embedded-pro/e-inverted-pendulum-hardware/docs/architecture.md

# Architecture

## Block diagram

```mermaid
graph LR
    BAT[3S LiPo 9.0-12.6 V] --> XT30[XT30] --> FUSE[Fuse 4 A] --> PP[Back-to-back PMOS AO4805<br/>on/off + reverse + soft-start]
    PP --> VM[VM bus<br/>SMBJ15A + 220 uF]
    VM --> DRV[DRV8711 + 4x CSD88537ND<br/>Rsense 2x 50 mOhm]
    DRV --> ML[Left MG310 + Hall A/B encoder]
    DRV --> MR[Right MG310 + Hall A/B encoder]
    VM --> DIV[VBAT divider] --> MCU
    VM --> BUCK[TPS62933 -> 5V0] --> LDO[TLV75533 -> 3V3]
    BUCK --> ENCP[Encoder VCC]
    ML -->|A B Z| BUF[ESD + SN74LVC3G17] --> MCU
    MR -->|A B Z| BUF
    LDO --> MCU[STM32WB55RGV6<br/>SMPS 10 uH + 10 nH]
    MCU -->|TIM1 CH1-4, BKIN| DRV
    MCU -->|SPI1| DRV
    MCU -->|SPI1| FLASH[W25Q16]
    MCU -->|SPI2 + DRDY| IMU[MPU-6500]
    MCU -->|RF1| MLPF[MLPF-WB55-01E3] --> PI[pi tuning DNP] --> ANT[printed IFA]
    MCU --> DBG[STDC14: SWD + VCP]
    MCU -->|PA7 via AHCT buffer| RGB[12 RGB LEDs on 5V0]
    MCU --> UI[Status LED, Qwiic, EEPROM, NFC tag]
```

Pins: `docs/pinmap.md`. Parts and stock: `bom/parts.csv`, checked by `scripts/jlc_stock.py`.

## Power tree and budget

Numbers marked **A** are ASSUMPTIONS to replace with datasheet maxima during the schematic phase.

| Rail | Load | Current | Source |
|---|---|---|---|
| 3V3 | STM32WB55, CPU + radio (TX 0 dBm 8.8 mA, SMPS bypass) | 30 mA | DS11929 radio current table; CPU allowance **A** |
| 3V3 | MPU-6500 accel + gyro | 3.5 mA | **A**, check the MPU-6500 datasheet |
| 3V3 | W25Q16 program/erase peak | 25 mA | **A**, check the W25Q16JV datasheet |
| 3V3 | Status LED at 2 mA, 2 × LVC3G17 | 5 mA | design choice |
| 3V3 | Qwiic allowance | 50 mA | design choice |
| **3V3 total** | | **≈ 115 mA** | TLV75533 (500 mA): (5.0 − 3.3) × 0.115 ≈ 0.20 W |
| 5V0 | 3V3 rail | 115 mA | above |
| 5V0 | 2 MG310 Hall encoders | 20 mA | **ASSUMPTION**, about 10 mA each for a Hall encoder board |
| 5V0 | 12 × WS2812B-2020-V6 at full white (D-035) | 432 mA | 12 mA per colour (WS2812B-2020-V6 p.1) × 3 × 12 |
| **5V0 total** | | **≈ 567 mA** | TPS62933 (3 A), L201 peak 0.83 A at 12.6 V (`docs/design-calcs.md`) |
| VBAT | 5V0 buck input at 9.9 V, η ≈ 0.85 | ≈ 340 mA | 5 × 0.567 / 0.85 / 9.9 |
| VBAT | Two motors at I_trip (peak) | 2 × 2.0 A | S0 (D-027) |
| VBAT | Two motors, continuous (rated) | 2 × 0.5 A | MG310 listing |
| **VBAT peak** | | **≈ 4.2 A** | 4 A fuse (1206FA-4A): 1.2 A continuous is within 75 % derating; 4.2 A recovery bursts (≪ 1 s) are 105 % of rating, which the fuse holds for ≥ 4 h; it opens at 250 % within 5 s (datasheet time-current table) |

## Safety chain (hardware part)

1. Power-on and reset (REQ-SYS-002, REQ-SAFE-009):
   - pull-downs on AIN1/AIN2/BIN1/BIN2 hold every bridge input low (tri-state);
   - a pull-down on SLEEPn keeps the DRV8711 asleep;
   - the DRV8711's SCS pull-down keeps SPI1 traffic from reaching it until firmware selects it.
2. A driver fault (nFAULT, open-drain) reaches TIM1_BKIN (PA6), which tri-states all four inputs in hardware with no firmware involved. It also reaches EXTI4 (PC4) to latch the fault (REQ-DRIVE-004).
3. Switching off the board while the wheels spin: the bridges' body diodes rectify the motor back-EMF onto VM, where the 220 µF and the SMBJ15A absorb it (HW-PWR-004, verified in S1).
4. The battery voltage is visible to the MCU (PC1) for the undervoltage fault (HW-PWR-006).
