embedded-pro/e-inverted-pendulum-hardware/docs/design-calcs.md

# Design calculations (Phase 1)

Generated by `python3 scripts/design_calcs.py`. Values feed `scripts/schgen/values.json` and the schematic generator; do not edit by hand.

| Block | Item | Value | Source |
|---|---|---|---|
| TPS62933F | f_sw | 1.2 MHz (RT pin to GND) | TPS62933 Table 7-1 / s9.3.5 (RT < 1 kOhm -> 1.2 MHz) |
| TPS62933F | R_FBB / R_FBT | 10k / 52.3k -> V_OUT 4.984 V (4.88-5.08 V over V_FB tolerance) | Eq. 1, R_FBB = 10 k recommended (s9.3.4); V_FB 784-816 mV (s8.5) |
| TPS62933F | L | 4.7 uH Sunlord SWPA4030S4R7MT (I_sat 3.2 A, I_rms 2 A); ripple 0.39 A at 9 V, 0.53 A at 12.6 V | Eq. 16 range 2.1-6.2 uH; ripple >= 10 % of 3 A for slope compensation (s10.2.2.7); peak at 0.3 A load ~0.6 A << I_sat; below I_HS_LIMIT 5.8 A only in a hard short |
| TPS62933F | C_OUT | 2 x 22 uF 25 V 0805 X5R (~22 uF effective at 5 V) + 100 nF | Table 10-2: 20 uF typ effective at 1.2 MHz / 5 V |
| TPS62933F | C_IN | 2 x 10 uF 25 V 0805 + 100 nF 50 V at the VIN pin | s10.2.2.9, s11 layout |
| TPS62933F | C_BST | 100 nF 16 V X7R | s10.2.2.5 |
| TPS62933F | C_SS | 47 nF -> t_SS = 6.8 ms (>= 6.8 nF minimum) | Eq. 6, I_SS 5.5 uA |
| TPS62933F | EN UVLO divider | R1 240k / R2 36k: start 9.11 V, stop 8.47 V, V_EN at 13.5 V = 1.83 V (< 5.5 V) | Eq. 3-5 (ideal R1 278k, R2 41.1k); stop at ~2.8 V/cell protects the LiPo, hysteresis >= 0.5 V (s9.3.6) |
| TLV75533P | C_IN / C_OUT | 1 uF 50 V X5R / 2.2 uF 25 V X5R (>= 0.47 uF effective) | SBVS320A s6.3, s8.1.1 |
| TLV75533P | dissipation | 0.20 W at 115 mA -> +45 C (R_thJA 231 C/W) | s6.4; load from docs/architecture.md |
| LSE | load caps | 2 x 6.8 pF C0G (computed 7.0 pF for C_L 6 pF, stray 2.5 pF) | AN2867 C_L formula (mcu-circuit-design s4); ST characterises LSE with 2 x 6.8 pF (DS11929 Table 41 n3) |
| LSE | drive | LSEDRV = 10 (firmware): g_m,crit ~0.67 uA/V vs 1.70 uA/V -> margin ~2.5 | DS11929 Table 54; NX3215SA C0 1.5 pF max, ESR 70 kOhm |
| HSE | crystal | NX2016SA-32MHZ-EXS00A-CS06654, no external caps (HSETUNE) | DS11929 Table 5 note 1 reference part; Table 52 C_L 6-8 pF, ESR <= 100 Ohm |
| VBAT sense | divider | 100k / 27k: ratio 0.2126, 12.6 V -> 2.679 V, 13.5 V -> 2.87 V | headroom below VDDA 3.3 V |
| VBAT sense | source impedance | 21.3 kOhm (< 50 kOhm R_AIN max), 100 nF bucket >> 20 x 5 pF C_ADC, tau 2.1 ms | DS11929 Table 73; analog-circuit-design s6 |
| VBAT sense | ratio error | +/-1.57 % worst case with 1 % parts (+/-66 mV per cell); calibrate per board + VREFINT | sensitivity of R2/(R1+R2) |
| Power path | V_GS at 9.0 V | -4.5 V (AO4805 R_DS(on) <= 26 mOhm at -4.5 V; limit +/-20 V; BZT52C15 clamps transients) | 100k gate-source / 100k to GND through the switch (S1) |
| Power path | V_GS at 13.5 V | -6.8 V (AO4805 R_DS(on) <= 26 mOhm at -4.5 V; limit +/-20 V; BZT52C15 clamps transients) | 100k gate-source / 100k to GND through the switch (S1) |
| Power path | soft start | 47 nF + 1k gate-to-VBAT (Miller): I_G ~0.08 mA -> ~1.7 V/ms, inrush ~0.48 A for ~7 ms | S1: 0.69 A peak with the 3.34 W logic load (D-035), 7.2 ms 10-90 % rise (was 44.6 A on hot plug with the Phase 1 values) |
| Power path | hot plug, switch off | 1 uF gate-source cap: V_GS step = -12.6 x 47n/(47n+1u) = -0.57 V (< |V_th,min| 1.0 V), FET stays off | S1: VBAT stays at 0.002 V (was 10.5 V with the Phase 1 values) |
| Power path | turn-off | tau = 100k x (1 uF + 47 nF) = 105 ms; don't switch off while the motors are driven | S1 regen cases: FET energy <= 7 mJ |
| Power path | TVS | SMBJ15A after the FETs: V_RWM 15 V > 13.5 V, V_C 24.4 V < 30 V (AO4805), 32 V (TPS62933) | Littelfuse SMBJ p.2; must not sit before the reverse-polarity FETs |
| DRV8711 | VM | 10 nF 50 V + 220 uF 35 V bulk; per bridge 10 uF 25 V 0805 + 100 nF 50 V at the half-bridges | SLVSC40 Critical Components p.4; power-pcb-layout s3.1 hot loop |
| DRV8711 | VCP / CP1-CP2 | 1 uF 50 V X5R VCP-to-VM / 100 nF 50 V X7R (>= VM + 12 V = 25.5 V) | SLVSC40 p.3-4 |
| DRV8711 | V5 / VINT / BEMF | 100 nF / 1 uF / 1 nF C0G to GND | SLVSC40 p.3-4 |
| DRV8711 | pull-ups | nFAULT, nSTALL 10k; SDATO (open-drain, shared MISO) 2.2k -> tau ~66 ns with 30 pF | SLVSC40 p.3; SPI <= 4 MHz (p.8) |
| DRV8711 | SLEEPn | 10k pull-down: no internal pull, keeps the driver asleep while the MCU is in reset | SLVSC40 p.3; AINx/BINx/RESET/SCS have internal pull-downs |
| DRV8711 | low-side clamps | SS34 Schottky from GND to each phase node: freewheel at -0.36 V instead of the -0.73 V body diode | S2; DRV8711 phase pins abs max -0.6 V (SLVSC40 Abs Max) |
| DRV8711 | Rsense | 50 mOhm 1206 1 W 75 ppm/C; 2.0 A trip -> 0.2 W; ISGAIN 20, TORQUE 186 | D-027; S0 (simulation/REPORT.md); Eq. 1 p.11 |
| DRV8711 | ISENSE filter | 0 Ohm fitted in each leg, 1 nF DNP across (fit 27-33 Ohm + 1 nF if noisy: RC 50-60 ns) | SLVSC40 p.16 Fig. 6 (symmetric, <= 500 Ohm, matched 1 %) |
| DRV8711 | firmware | IDRIVE 00 (50/100 mA, default); TBLANK >= 1.2 us (sense amp settling); SCLK <= 4 MHz; SCS active-high GPIO | SLVSC40 p.7-8 |
| Encoders | input RC | 100 Ohm + 1 nF -> f_c 1.59 MHz (> 2 x 105 kHz max channel rate), rise 220 ns | S0 encoder rate; analog-circuit-design s5 |
| Encoders | OC pull-ups (DNP) | 2.2k to encoder VCC: OK to ~500 lines at full speed; for 1000-line OC encoders fit 1k and reduce C to 220 pF | tau = R x (1 nF + cable) |
| Encoders | buffer | SN74LVC3G17 at 3V3: V_T+ <= 1.87 V, inputs 5.5 V tolerant with I_off | SCES470D p.3-4 |
| Qwiic I2C | pull-ups | 2.2k (window 967-3541 Ohm, Fast mode, C_b 100 pF) | SLVA689A |
| Status LED | series R | green 470 Ohm on PB0 (V_F 2.45 V at 2 mA -> ~1.8 mA) | KT-0603G IF-VF curve p.5 |
| RGB LEDs | chain | 12 x WS2812B-2020-V6 on +5V, 12 mA per colour, 36 mA per LED at full white -> 432 mA for the chain; 100 nF per LED, 10 uF at the chain input | WS2812B-2020-V6 p.1 (12 mA per channel), p.3 (36 mA colour mix), p.6 (C_n 100 nF); 10 uF ASSUMPTION |
| RGB LEDs | data level | LED V_IH = 0.55 VDD = 2.75 V at 5 V; MCU V_OH >= VDD - 0.4 = 2.9 V (0.15 V margin direct), so SN74AHCT1G125 on +5V: V_IH 2.0 V (0.9 V margin), 5 V output | WS2812B-2020-V6 p.3; SCLS378L p.3; DS11929 Output voltage characteristics (VOH, 8 mA) |
| RGB LEDs | data line | 10k pull-down at the buffer input (data low while PA7 floats in reset); 33 Ohm source termination at the buffer output | SCLS378L note 3 (inputs must not float); mcu-circuit-design s9 |
| +5V budget | load | RGB chain 432 mA + 3V3 LDO 115 mA + encoders 20 mA = 567 mA; L201 peak 0.83 A at 12.6 V << I_sat 3.2 A, TPS62933F 3 A | docs/architecture.md; L201 ripple row above |
| BOOT0 | entry | 10k pull-down, no button: test pad TP302 to +3V3 at reset, or nSWBOOT0 / nBOOT0 option bytes over SWD | mcu-circuit-design s3; RM0434 option bytes |
