embedded-pro/e-inverted-pendulum-hardware/docs/pinmap.md

# Pin map: STM32WB55RGV6 (VFQFPN68)

- **Source of truth:** `pin-data/pinmap.csv`.
- **Validation:** `scripts/check_pinmap.py --firmware ../e-inverted-pendulum`.
- **Package data:** `pin-data/stm32wb55rgvx_vfqfpn68.csv`, extracted by
  `scripts/extract_pin_data.py` from KiCad 10's `MCU_ST_STM32WB:STM32WB55RGVx` symbol (identical to KiCad 9's), which is
  generated from ST's STM32_open_pin_data. Spot-checked against DS11929 Rev 11 Tables 16 and 18.

The plan called for a CubeMX `.ioc`. STM32CubeMX can't run in this environment, so the script
replaces it for bonding, alternate functions, EXTI uniqueness and firmware parity. Generating the
`.ioc` (clock tree, SMPS, LSE) is left for someone with CubeMX installed. It doesn't block the
schematic.

## What the check enforces

1. Every pin is bonded on VFQFPN68.
2. Every alternate function or ADC channel exists on its pin.
3. One signal per pin. The only shared net is `DRV_NFAULT`, which reaches PA6 (TIM1_BKIN) and
   PC4 (EXTI4), as the firmware expects.
4. Unique EXTI lines. In use: 0 (button), 2 (NFC GPO), 3 and 5 (encoder index; idle with the MG310, D-028),
   4 (driver fault), 6 (IMU data-ready).
5. Firmware parity: all 26 pins declared in `targets/platform_implementations/st/*.hpp` sit
   on the same pins.

## Firmware-visible changes

None to existing pins. New signals for the firmware's board target:

| Signal | Pin | Use |
|---|---|---|
| FLASH_CS | PA15 | W25Q16 on SPI1 (shared with the DRV8711; mode 0 suits both) |
| VBAT_SENSE | PC1 / ADC1_IN2 | battery voltage, 100 k/27 k divider |
| LED_RGB | PA7 / TIM17_CH1 | 12 × WS2812B-2020-V6 chain through an SN74AHCT1G125 (D-035); green status LED stays on PB0 |
| I2C3 SCL/SDA | PB10 / PB11 | Qwiic expansion, M24C64 EEPROM (0x50), ST25DV04KC NFC tag (0x53/0x57) |
| NFC_GPO | PA2 / EXTI2 | ST25DV04KC GPO, open drain with a 10 k pull-up (D-030) |
| DRV_STALLN | PB2 | optional DRV8711 nSTALL input |

## Consequences

- **No index:** the MG310 encoders are A/B only; PC5 and PC3 read low (D-028).
- **No SWO:** PB3 is SPI1_SCK.
- **No USB:** PA11 is TIM1_CH4 (D-009).
- **SWD only:** PA15 (JTDI) is FLASH_CS, so firmware must not enable JTAG.
- **Reset-safe bridge:** PA8–PA11 and PB8 get pull-downs so the bridge stays tri-stated and the
  driver asleep while the MCU is in reset (HW-DRV-005).
