embedded-pro/e-inverted-pendulum-hardware/docs/images/3d_top.png

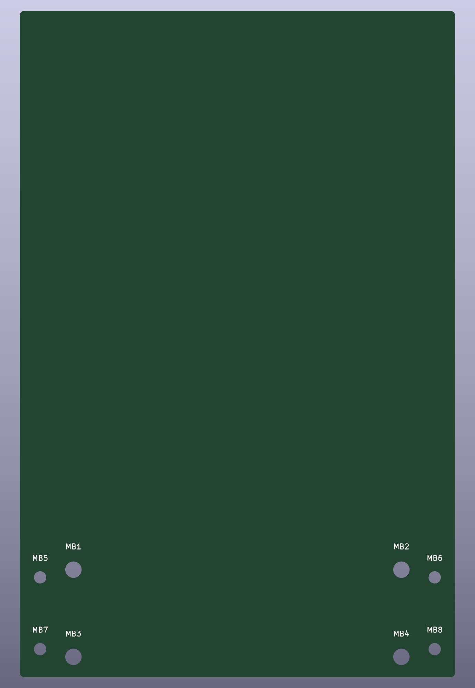
docs/images/3d_top.png
