embedded-pro/e-inverted-pendulum-hardware/docs/images/bottom.png

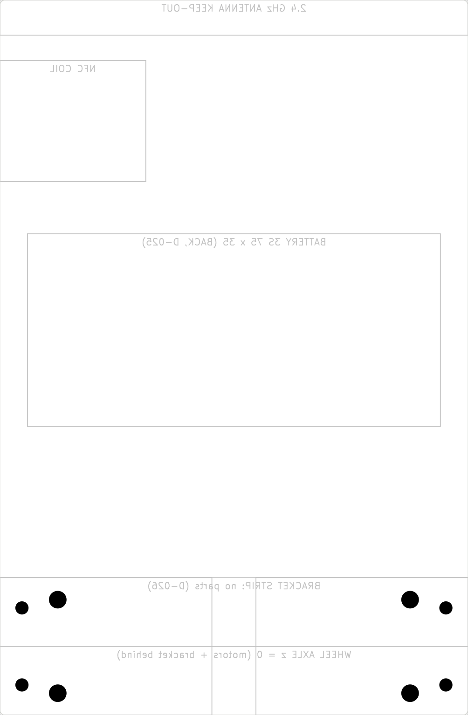
docs/images/bottom.png
