embedded-pro/e-inverted-pendulum-hardware/docs/images/L1_F.Cu.png

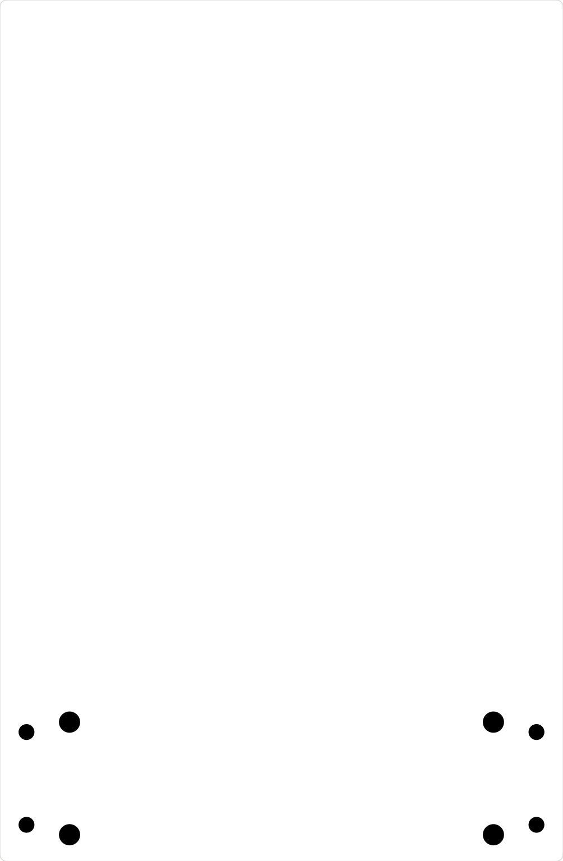
docs/images/L1_F.Cu.png
