embedded-pro/e-inverted-pendulum-hardware/docs/images/overview.png

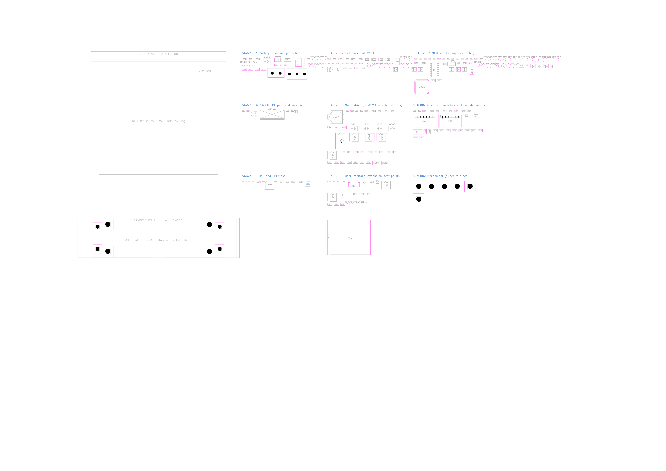
docs/images/overview.png
