embedded-pro/e-inverted-pendulum-hardware/docs/images/placement.png

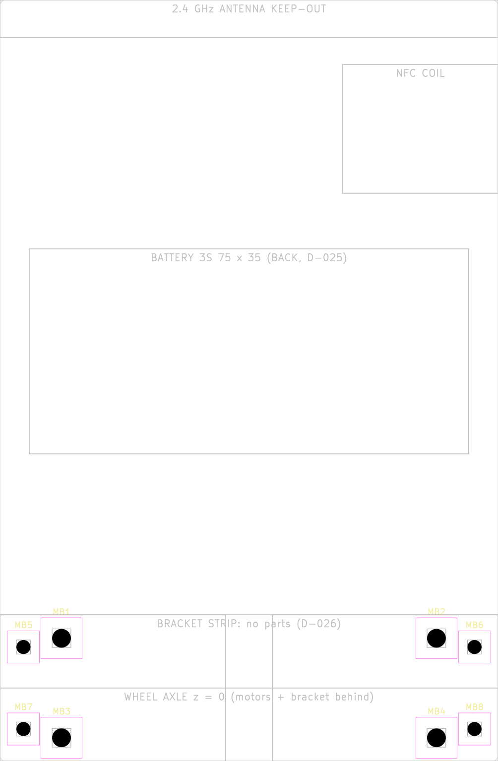
docs/images/placement.png
