embedded-pro/e-inverted-pendulum-hardware/simulation/plots/s1_regen.png

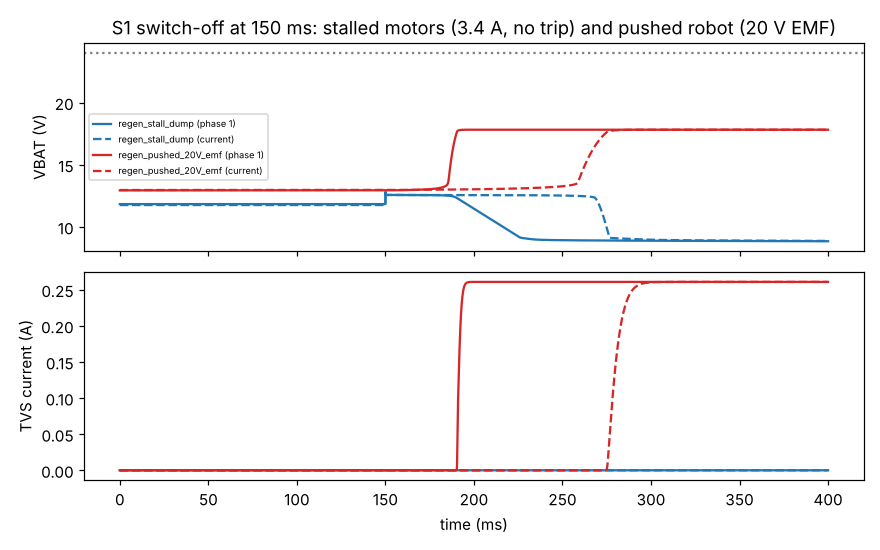
simulation/plots/s1_regen.png
