embedded-pro/e-inverted-pendulum-hardware/simulation/plots/s1_switch_on.png

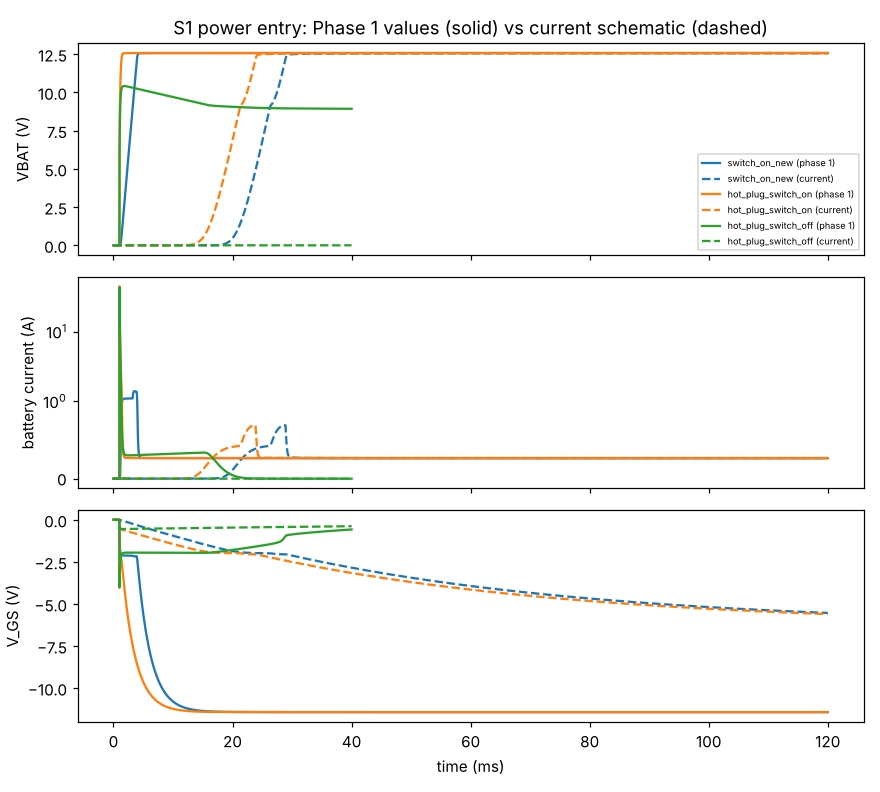
simulation/plots/s1_switch_on.png
