embedded-pro/e-inverted-pendulum-hardware/simulation/plots/s2_edges.png

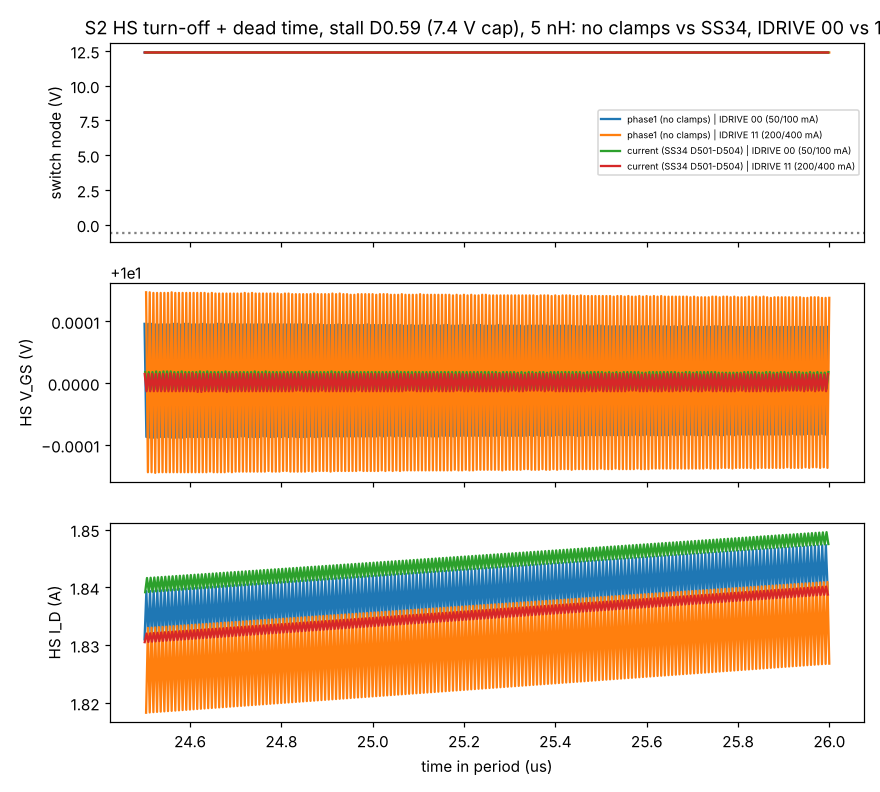
simulation/plots/s2_edges.png
