embedded-pro/e-inverted-pendulum-hardware/simulation/plots/s3_bus.png

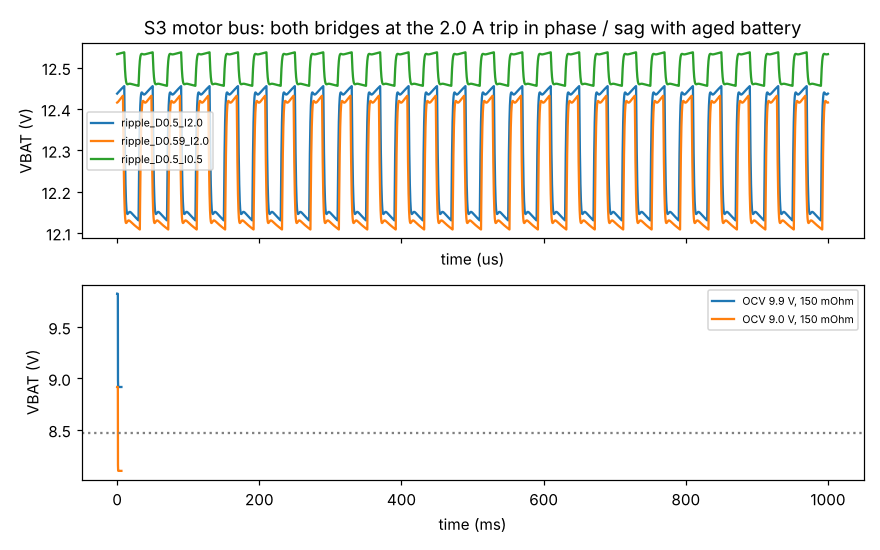
simulation/plots/s3_bus.png
