embedded-pro/e-inverted-pendulum-hardware/simulation/plots/s4_rails.png

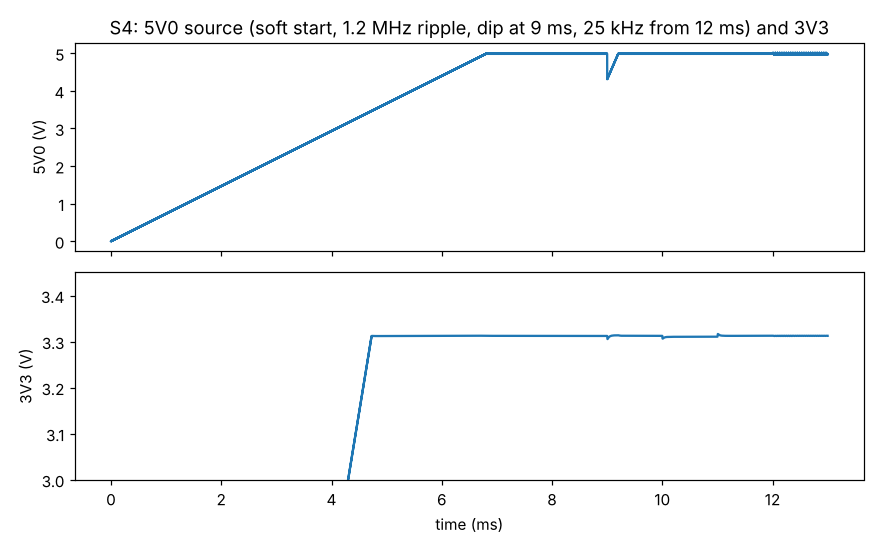
simulation/plots/s4_rails.png
