embedded-pro/e-inverted-pendulum-hardware/simulation/plots/sizing_recovery.png

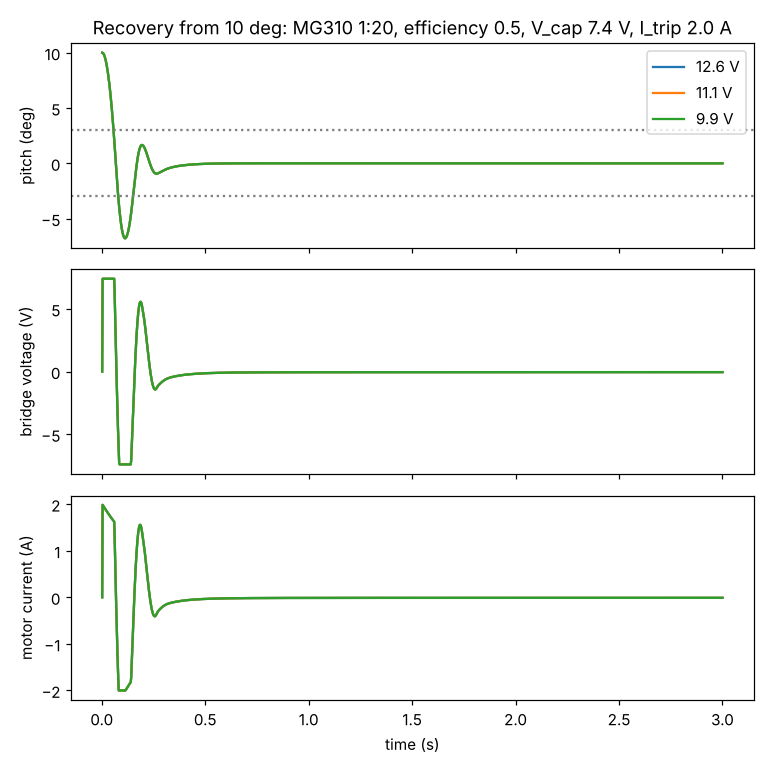
simulation/plots/sizing_recovery.png
