embedded-pro/e-inverted-pendulum-hardware/bom/bom.csv

group | function | mpn | lcsc | qty | notes
schematic | 47nF 50V | CL10B473KB8NNNC | C1622 | 2 | C101,C205
schematic | 1uF 50V | CL10A105KB8NNNC | C15849 | 6 | C102,C209,C311,C313,C509,C512
schematic | 100nF 50V | CC0603KRX7R9BB104 | C14663 | 7 | C103,C203,C208,C503,C506,C510,C602
schematic | 10uF 25V | CL21A106KAYNNNE | C15850 | 5 | C201,C202,C502,C505,C805
schematic | 100nF 16V | CL05B104KO5NNNC | C1525 | 30 | C204,C301,C302,C303,C304,C305,C307,C312,C317,C511,C606,C610,C701,C703,C704,C801,C802,C803,C806,C807,C808,C809,C810,C811,C812,C813,C814,C815,C816,C817
schematic | 22uF 25V | CL21A226MAQNNNE | C45783 | 2 | C206,C207
schematic | 2.2uF 25V | CL10A225KO8NNNC | C23630 | 1 | C210
schematic | 4.7uF 10V | CL05A475MP5NRNC | C23733 | 3 | C306,C309,C314
schematic | 100pF 50V | CL05C101JB5NNNC | C26409 | 1 | C308
schematic | 10nF 50V | CL10B103KB8NNNC | C1589 | 3 | C310,C508,C702
schematic | 6.8pF 50V | CL05C6R8CB5NNNC | C318598 | 2 | C315,C316
schematic | 220u 35V | EEEFK1V221P | C178562 | 1 | C507
schematic | 1nF 50V | CL05C102JB5NNNC | C307441 | 1 | C513
schematic | 10uF 10V | CL10A106KP8NNNC | C19702 | 1 | C601
schematic | 1nF 50V | CL10B102KB8NNNC | C1588 | 4 | C604,C605,C608,C609
schematic | BZT52C15 | BZT52C15 | C2104 | 1 | D101
schematic | SMBJ15A | SMBJ15A | C83846 | 1 | D102
schematic | SS34 | SS34 | C8678 | 4 | D501,D502,D503,D504
schematic | green | KT-0603G | C12624 | 1 | D801
schematic | WS2812B-2020 | WS2812B-2020-V6 | C52917434 | 12 | D802,D803,D804,D805,D806,D807,D808,D809,D810,D811,D812,D813
schematic | 4A fast | 1206FA-4A | C2937379 | 1 | F101
schematic | PTC 100mA | SMD0805P010TF | C20975 | 1 | F601
schematic | BLM18PG221SN1D | BLM18PG221SN1D | C80165 | 1 | FB301
schematic | MLPF-WB55-01E3 | MLPF-WB55-01E3 | C2651048 | 1 | FL401
schematic | XT30 battery | XT30UPB-F30.G.Y | C108769 | 1 | J101
schematic | STDC14 | FTSH-107-01-L-DV-K | C5307809 | 1 | J301
schematic | Motor left,Motor right | S6B-PH-K-S(LF)(SN) | C157920 | 2 | J601,J602
schematic | Qwiic | SM04B-SRSS-TB(LF)(SN) | C160404 | 1 | J801
schematic | 4.7uH | SWPA4030S4R7MT | C57269 | 1 | L201
schematic | 10uH | LQM21FN100M80L | C162582 | 1 | L301
schematic | 10nH | LQG15HS10NJ02D | C77103 | 1 | L302
schematic | AO4805 | AO4805 | C3040596 | 1 | Q101
schematic | CSD88537ND | CSD88537ND | C117439 | 4 | Q501,Q502,Q503,Q504
schematic | 100k | 0603WAF1003T5E | C25803 | 3 | R101,R102,R104
schematic | 1k | 0603WAF1001T5E | C21190 | 1 | R103
schematic | 27k | 0603WAF2702T5E | C22967 | 1 | R105
schematic | 240k | 0603WAF2403T5E | C4197 | 1 | R201
schematic | 36k | 0603WAF3602T5E | C23147 | 1 | R202
schematic | 52.3k | 0603WAF5232T5E | C23198 | 1 | R203
schematic | 10k | 0603WAF1002T5E | C25804 | 11 | R204,R302,R515,R516,R518,R701,R702,R703,R704,R803,R810
schematic | 33 | 0603WAF330JT5E | C23140 | 2 | R301,R802
schematic | 0 | 0402WGF0000TCE | C17168 | 1 | R401
schematic | 0 | 0603WAF0000T5E | C21189 | 13 | R501,R502,R503,R504,R505,R506,R507,R508,R510,R511,R513,R514,R601
schematic | 50m | HoLR1206-1W-50mR-1%-75ppm | C601102 | 2 | R509,R512
schematic | 2.2k | 0603WAF2201T5E | C4190 | 3 | R517,R808,R809
schematic | 100 | 0603WAF1000T5E | C22775 | 4 | R604,R606,R608,R610
schematic | 470 | 0603WAF4700T5E | C23179 | 1 | R801
schematic | SS-12D10L5 | SS-12D10L5 | C319012 | 1 | SW101
schematic | TPS62933F | TPS62933FDRLR | C5219272 | 1 | U201
schematic | TLV75533P | TLV75533PDBVR | C404027 | 1 | U202
schematic | STM32WB55RGV6 | STM32WB55RGV6 | C401505 | 1 | U301
schematic | DRV8711 | DRV8711DCPR | C60013 | 1 | U501
schematic | TPD4E05U06QDQARQ1 | TPD4E05U06QDQARQ1 | C81353 | 3 | U601,U603,U801
schematic | SN74LVC3G17DCTR | SN74LVC3G17DCTR | C18213 | 2 | U602,U604
schematic | MPU-6500 | MPU-6500 | C50278 | 1 | U701
schematic | W25Q16JVSSIQ | W25Q16JVSSIQ | C131025 | 1 | U702
schematic | M24C64-RMN6TP | M24C64-RMN6TP | C79988 | 1 | U802
schematic | ST25DV04KC-IE8S3 | ST25DV04KC-IE8S3 | C5221752 | 1 | U803
schematic | SN74AHCT1G125 | SN74AHCT1G125DBVR | C7484 | 1 | U804
schematic | 32MHz | NX2016SA-32MHZ-EXS00A-CS06654 | C5441424 | 1 | Y301
schematic | 32.768kHz | NX3215SA-32.768K-STD-MUA-14 | C156244 | 1 | Y302
