embedded-pro/e-inverted-pendulum-hardware/mechanical/mass_budget.csv

item | qty | mass_g | z_mm | y_mm | shape | height_mm | depth_mm | source
axle | 1 | 0 | 0 | 18.8 | axle | 0 | 0 | Pivot (D-026): WHEELTEC U-bracket leg hole 18 mm from the base, base flat on the plate's back (0.8 mm half plate); z at the centre of the 25 mm strip, 12.5 mm above the bottom edge
pcb_plate | 1 | 33 | 52.5 | 0 | plate | 130 | 1.6 | D-024 outline 85 x 130 x 1.6 mm FR-4 at 1.85 g/cm3, spanning z -12.5..117.5 mm
pcb_components | 1 | 30 | 60 | -2 | point | 0 | 0 | ASSUMPTION populated-board estimate (all parts on the front, D-015), incl. NFC/EEPROM and PH connectors
battery_3s_1000mah | 1 | 85 | 57.5 | 11.8 | box | 35 | 22 | ASSUMPTION 3S 1000 mAh 75 x 35 x 22 mm flat on the back (D-025), z 40..75 mm
battery_cradle | 1 | 10 | 57.5 | 6 | point | 0 | 0 | ASSUMPTION printed cradle on 4 x M3
motor_mg310 | 2 | 65 | 0 | 18.8 | cylinder | 25 | 25 | ASSUMPTION MG310 1:20 with Hall encoder, 60-70 g (seller listings); axis on the wheel axle
bracket_wheeltec | 1 | 64 | 0 | 7.1 | point | 0 | 0 | derived: 2 mm steel U, base 102 x 25 + two 25 x 31 legs = 8.2 cm3 at 7.85 g/cm3; centroid between the base (y 1.8) and the legs (y 15.8)
screws_cables | 1 | 15 | 10 | 2 | point | 0 | 0 | ASSUMPTION bracket screws, motor cables
xt30_lead | 1 | 10 | 40 | -4 | point | 0 | 0 | ASSUMPTION XT30 plug and battery lead on the left edge
bumpers | 1 | 10 | 100 | 0 | point | 0 | 0 | ASSUMPTION nylon bumpers near the top
wheel | 2 | 30 | 0 | 18.8 | wheel | 65 | 26 | Owner: 65 mm wheels (2026-11-13); mass ASSUMPTION 30 g; excluded from body mass
