embedded-pro/e-inverted-pendulum-hardware/simulation/results/sizing_sweep.csv

v_cap | i_trip | efficiency | vbat | vbat_case | reflected_inertia | recover_10deg | settle_time_10deg | peak_current_10deg | peak_duty_10deg | max_recoverable_deg | cruise_v_1p0_mps | cruise_v_1p5_mps
7.4 | 1.0 | low | 12.6 | full | 0.0007999999999999999 | True | 0.382 | 1.0 | 0.5873015873015873 | 11.95703125 | 4.191046038652143 | 6.064569057978214
7.4 | 1.0 | low | 11.1 | nominal | 0.0007999999999999999 | True | 0.382 | 1.0 | 0.6666666666666667 | 11.95703125 | 4.191046038652143 | 6.064569057978214
7.4 | 1.0 | low | 9.9 | arm_min | 0.0007999999999999999 | True | 0.382 | 1.0 | 0.7474747474747475 | 11.95703125 | 4.191046038652143 | 6.064569057978214
7.4 | 1.0 | nominal | 12.6 | full | 0.0007999999999999999 | True | 0.192 | 1.0 | 0.5873015873015873 | 16.33984375 | 4.191046038652143 | 6.064569057978214
7.4 | 1.0 | nominal | 11.1 | nominal | 0.0007999999999999999 | True | 0.192 | 1.0 | 0.6666666666666667 | 16.33984375 | 4.191046038652143 | 6.064569057978214
7.4 | 1.0 | nominal | 9.9 | arm_min | 0.0007999999999999999 | True | 0.192 | 1.0 | 0.7474747474747475 | 16.33984375 | 4.191046038652143 | 6.064569057978214
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
