embedded-pro/e-inverted-pendulum-hardware/hardware/e-inverted-pendulum/e-inverted-pendulum.kicad_pcb

## KiCad design hardware/e-inverted-pendulum/e-inverted-pendulum.kicad_pcb (2026-11-14)

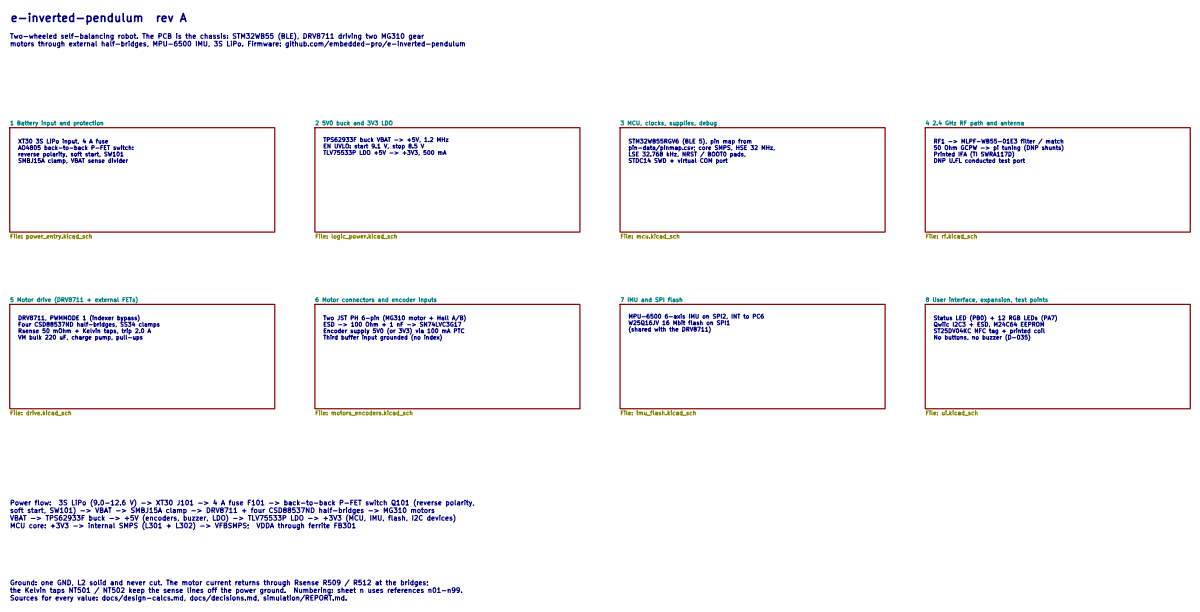
[picture p20: schematic e-inverted-pendulum.kicad_sch, e-inverted-pendulum: self-balancing robot chassis PCB]

Notes on the sheet:
Two JST PH 6-pin (MG310 motor + Hall A/B) ESD -> 100 Ohm + 1 nF -> SN74LVC3G17 Encoder supply 5V0 (or 3V3) via 100 mA PTC Third buffer input grounded (no index)
DRV8711, PWMMODE 1 (indexer bypass) Four CSD88537ND half-bridges, SS34 clamps Rsense 50 mOhm + Kelvin taps, trip 2.0 A VM bulk 220 uF, charge pump, pull-ups
RF1 -> MLPF-WB55-01E3 filter / match 50 Ohm GCPW -> pi tuning (DNP shunts) Printed IFA (TI SWRA117D) DNP U.FL conducted test port
MPU-6500 6-axis IMU on SPI2, INT to PC6 W25Q16JV 16 Mbit flash on SPI1 (shared with the DRV8711)
Status LED (PB0) + 12 RGB LEDs (PA7) Qwiic I2C3 + ESD, M24C64 EEPROM ST25DV04KC NFC tag + printed coil No buttons, no buzzer (D-035)
Two-wheeled self-balancing robot. The PCB is the chassis: STM32WB55 (BLE), DRV8711 driving two MG310 gear motors through external half-bridges, MPU-6500 IMU, 3S LiPo. Firmware: github.com/embedded-pro/e-inverted-pendulum
XT30 3S LiPo input, 4 A fuse AO4805 back-to-back P-FET switch: reverse polarity, soft start, SW101 SMBJ15A clamp, VBAT sense divider
e-inverted-pendulum rev A
TPS62933F buck VBAT -> +5V, 1.2 MHz EN UVLO: start 9.1 V, stop 8.5 V TLV75533P LDO +5V -> +3V3, 500 mA
Ground: one GND, L2 solid and never cut. The motor current returns through Rsense R509 / R512 at the bridges; the Kelvin taps NT501 / NT502 keep the sense lines off the power ground. Numbering: sheet n uses references n01-n99. Sources for every value: docs/design-calcs.md, docs/decisions.md, simula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
STM32WB55RGV6 (BLE 5), pin map from pin-data/pinmap.csv; core SMPS, HSE 32 MHz, LSE 32.768 kHz, NRST / BOOT0 pads, STDC14 SWD + virtual COM port
Power flow: 3S LiPo (9.0-12.6 V) -> XT30 J101 -> 4 A fuse F101 -> back-to-back P-FET switch Q101 (reverse polarity, soft start, SW101) -> VBAT -> SMBJ15A clamp -> DRV8711 + four CSD88537ND half-bridges -> MG310 motors VBAT -> TPS62933F buck -> +5V (encoders, buzzer, LDO) -> TLV75533P LDO -> +3V3 (M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

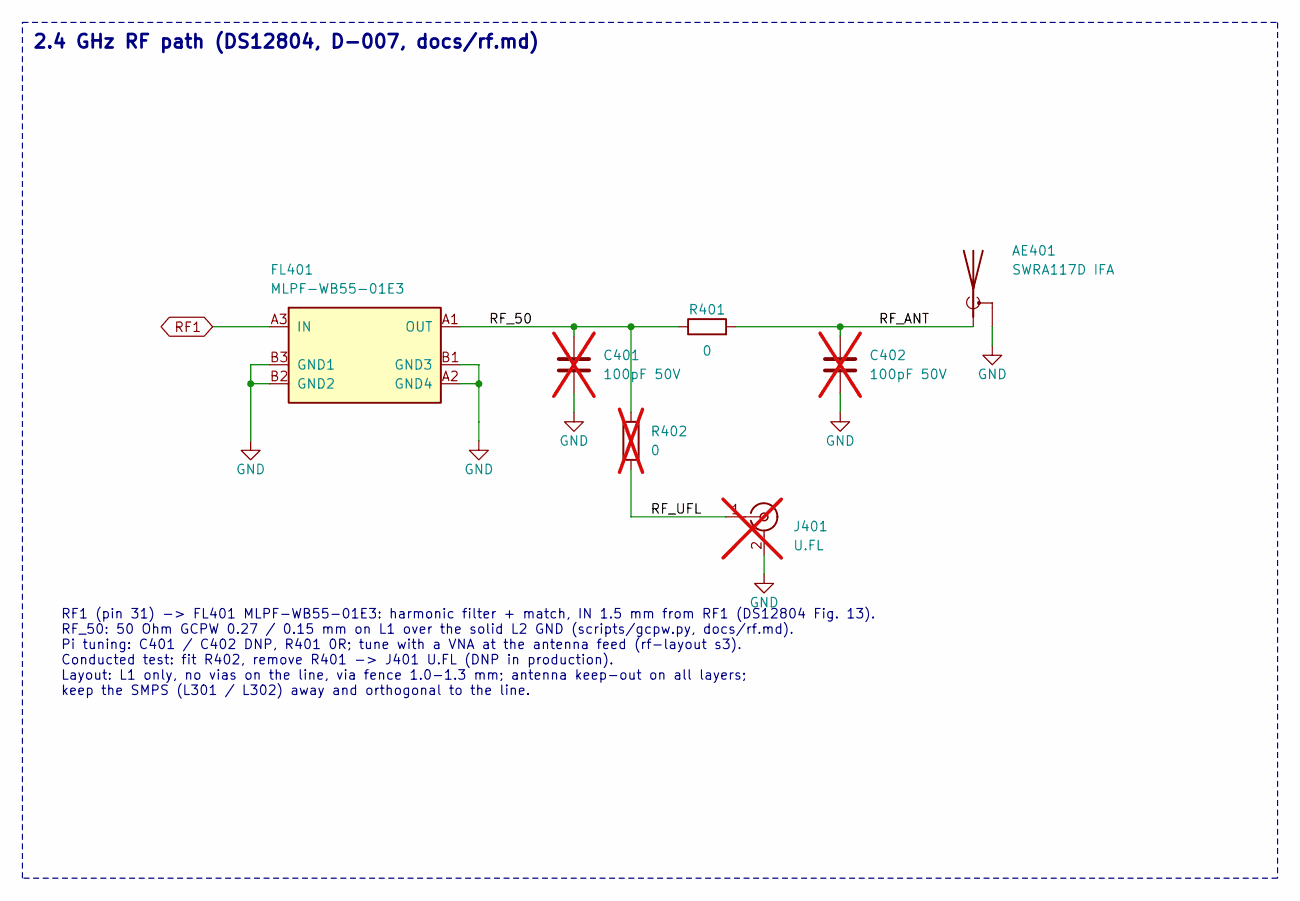
[picture p21: schematic rf.kicad_sch, 4 2.4 GHz RF path and antenna]

Parts:
AE401: SWRA117D IFA; Texas_SWRA117D_2.4GHz_Left
C401, C402: 100pF 50V; C_0402_1005Metric; MPN CL05C101JB5NNNC; LCSC C26409; not fitted
FL401: MLPF-WB55-01E3; ST_MLPF-WB55-01E3; MPN MLPF-WB55-01E3; LCSC C2651048
J401: U.FL; U.FL_Hirose_U.FL-R-SMT-1_Vertical; MPN BWU.FL-IPEX1; LCSC C5137195; not fitted
R401: 0; R_0402_1005Metric; MPN 0402WGF0000TCE; LCSC C17168
R402: 0; R_0402_1005Metric; MPN 0402WGF0000TCE; LCSC C17168; not fitted

Connections:
/4 2.4 GHz RF path and antenna/RF_50: C401.1, FL401.A1 (OUT), R401.1, R402.1
/4 2.4 GHz RF path and antenna/RF_ANT: AE401.1 (A), C402.1, R401.2
/4 2.4 GHz RF path and antenna/RF_UFL: J401.1 (In), R402.2
GND: AE401.2 (Shield), C401.2, C402.2, FL401.A2 (GND4), FL401.B1 (GND3), FL401.B2 (GND2), FL401.B3 (GND1), J401.2 (Ext); also elsewhere on the board
RF1: FL401.A3 (IN); also elsewhere on the board

Notes on the sheet:
2.4 GHz RF path (DS12804, D-007, docs/rf.md)
RF1 (pin 31) -> FL401 MLPF-WB55-01E3: harmonic filter + match, IN 1.5 mm from RF1 (DS12804 Fig. 13). RF_50: 50 Ohm GCPW 0.27 / 0.15 mm on L1 over the solid L2 GND (scripts/gcpw.py, docs/rf.md). Pi tuning: C401 / C402 DNP, R401 0R; tune with a VNA at the antenna feed (rf-layout s3). Conducted test: 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

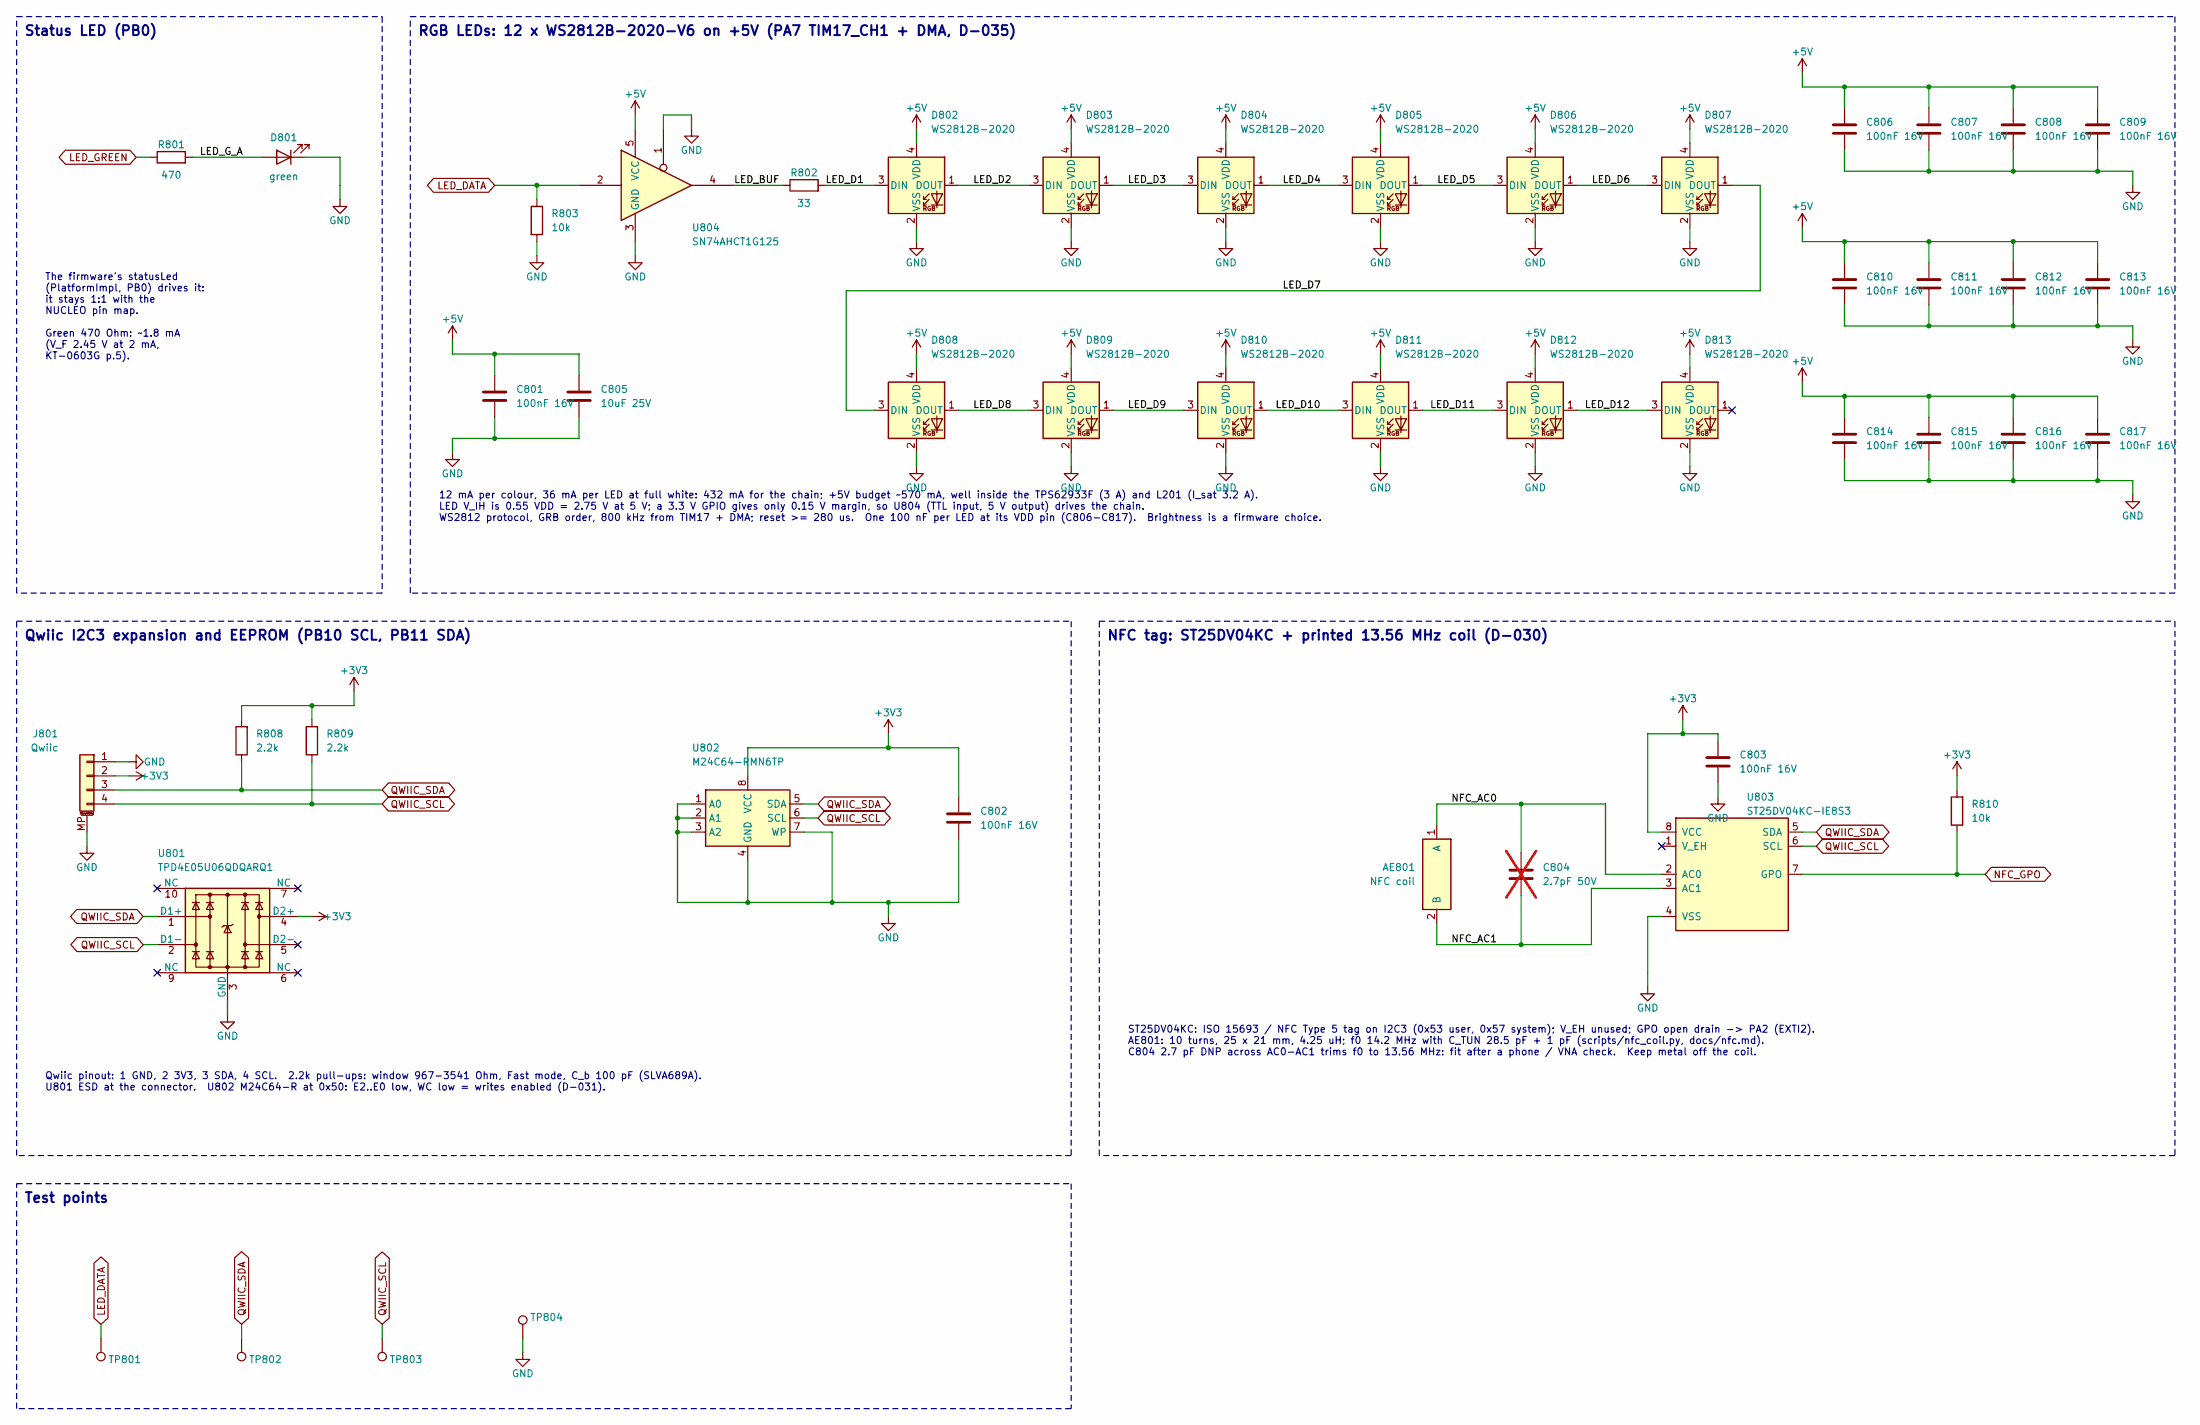
[picture p22: schematic ui.kicad_sch, 8 User interface, expansion, test points]

Parts:
AE801: NFC coil; NFC_Coil_25x21mm
C801, C802, C803, C806, C807, C808, C809, C810, C811, C812, C813, C814, C815, C816, C817: 100nF 16V; C_0402_1005Metric; MPN CL05B104KO5NNNC; LCSC C1525
C804: 2.7pF 50V; C_0402_1005Metric; MPN CL05C2R7CB5NNNC; LCSC C318593; not fitted
C805: 10uF 25V; C_0805_2012Metric; MPN CL21A106KAYNNNE; LCSC C15850
D801: green; LED_0603_1608Metric; MPN KT-0603G; LCSC C12624
D802, D803, D804, D805, D806, D807, D808, D809, D810, D811, D812, D813: WS2812B-2020; LED_WS2812B-2020_PLCC4_2.0x2.0mm; MPN WS2812B-2020-V6; LCSC C52917434
J801: Qwiic; JST_SH_SM04B-SRSS-TB_1x04-1MP_P1.00mm_Horizontal; MPN SM04B-SRSS-TB(LF)(SN); LCSC C160404
R801: 470; R_0603_1608Metric; MPN 0603WAF4700T5E; LCSC C23179
R802: 33; R_0603_1608Metric; MPN 0603WAF330JT5E; LCSC C23140
R803, R810: 10k; R_0603_1608Metric; MPN 0603WAF1002T5E; LCSC C25804
R808, R809: 2.2k; R_0603_1608Metric; MPN 0603WAF2201T5E; LCSC C4190
TP801: LED_DATA; TestPoint_Pad_D1.0mm
TP802: QWIIC_SDA; TestPoint_Pad_D1.0mm
TP803: QWIIC_SCL; TestPoint_Pad_D1.0mm
TP804: GND; TestPoint_Pad_D1.5mm
U801: TPD4E05U06QDQARQ1; USON-10_2.5x1.0mm_P0.5mm; MPN TPD4E05U06QDQARQ1; LCSC C81353
U802: M24C64-RMN6TP; SOIC-8_3.9x4.9mm_P1.27mm; MPN M24C64-RMN6TP; LCSC C79988
U803: ST25DV04KC-IE8S3; SOIC-8_3.9x4.9mm_P1.27mm; MPN ST25DV04KC-IE8S3; LCSC C5221752
U804: SN74AHCT1G125; SOT-23-5; MPN SN74AHCT1G125DBVR; LCSC C7484

Connections:
+3V3: C802.1, C803.1, J801.2, R808.2, R809.2, R810.2, U801.4 (D2+), U802.8 (VCC), U803.8 (VCC); also elsewhere on the board
+5V: C801.1, C805.1, C806.1, C807.1, C808.1, C809.1, C810.1, C811.1, C812.1, C813.1, C814.1, C815.1, C816.1, C817.1, D802.4 (VDD), D803.4 (VDD), D804.4 (VDD), D805.4 (VDD), D806.4 (VDD), D807.4 (VDD), D808.4 (VDD), D809.4 (VDD), D810.4 (VDD), D811.4 (VDD), D812.4 (VDD), D813.4 (VDD), U804.5 (VCC); also elsewhere on the board
/8 User interface, expansion, test points/LED_BUF: R802.1, U804.4
/8 User interface, expansion, test points/LED_D1: D802.3 (DIN), R802.2
/8 User interface, expansion, test points/LED_D2: D802.1 (DOUT), D803.3 (DIN)
/8 User interface, expansion, test points/LED_D3: D803.1 (DOUT), D804.3 (DIN)
/8 User interface, expansion, test points/LED_D4: D804.1 (DOUT), D805.3 (DIN)
/8 User interface, expansion, test points/LED_D5: D805.1 (DOUT), D806.3 (DIN)
/8 User interface, expansion, test points/LED_D6: D806.1 (DOUT), D807.3 (DIN)
/8 User interface, expansion, test points/LED_D7: D807.1 (DOUT), D808.3 (DIN)
/8 User interface, expansion, test points/LED_D8: D808.1 (DOUT), D809.3 (DIN)
/8 User interface, expansion, test points/LED_D9: D809.1 (DOUT), D810.3 (DIN)
/8 User interface, expansion, test points/LED_D10: D810.1 (DOUT), D811.3 (DIN)
/8 User interface, expansion, test points/LED_D11: D811.1 (DOUT), D812.3 (DIN)
/8 User interface, expansion, test points/LED_D12: D812.1 (DOUT), D813.3 (DIN)
/8 User interface, expansion, test points/LED_G_A: D801.2 (A), R801.2
/8 User interface, expansion, test points/NFC_AC0: AE801.1 (A), C804.1, U803.2 (AC0)
/8 User interface, expansion, test points/NFC_AC1: AE801.2 (B), C804.2, U803.3 (AC1)
GND: C801.2, C802.2, C803.2, C805.2, C806.2, C807.2, C808.2, C809.2, C810.2, C811.2, C812.2, C813.2, C814.2, C815.2, C816.2, C817.2, D801.1 (K), D802.2 (VSS), D803.2 (VSS), D804.2 (VSS), D805.2 (VSS), D806.2 (VSS), D807.2 (VSS), D808.2 (VSS), D809.2 (VSS), D810.2 (VSS), D811.2 (VSS), D812.2 (VSS), D813.2 (VSS), J801.1, J801.MP (MountPin), R803.2, TP804.1, U801.3 (GND), U801.8 (GND), U802.1 (A0), U802.2 (A1), U802.3 (A2), U802.4 (GND), U802.7 (WP), U803.4 (VSS), U804.1, U804.3 (GND); also elsewhere on the board
LED_DATA: R803.1, TP801.1, U804.2; also elsewhere on the board
LED_GREEN: R801.1; also elsewhere on the board
NFC_GPO: R810.1, U803.7 (GPO); also elsewhere on the board
QWIIC_SCL: J801.4, R809.1, TP803.1, U801.2 (D1-), U802.6 (SCL), U803.6 (SCL); also elsewhere on the board
QWIIC_SDA: J801.3, R808.1, TP802.1, U801.1 (D1+), U802.5 (SDA), U803.5 (SDA); also elsewhere on the board

Notes on the sheet:
NFC tag: ST25DV04KC + printed 13.56 MHz coil (D-030)
Status LED (PB0)
RGB LEDs: 12 x WS2812B-2020-V6 on +5V (PA7 TIM17_CH1 + DMA, D-035)
Test points
Qwiic pinout: 1 GND, 2 3V3, 3 SDA, 4 SCL. 2.2k pull-ups: window 967-3541 Ohm, Fast mode, C_b 100 pF (SLVA689A). U801 ESD at the connector. U802 M24C64-R at 0x50: E2..E0 low, WC low = writes enabled (D-031).
The firmware's statusLed (PlatformImpl, PB0) drives it: it stays 1:1 with the NUCLEO pin map. Green 470 Ohm: ~1.8 mA (V_F 2.45 V at 2 mA, KT-0603G p.5).
12 mA per colour, 36 mA per LED at full white: 432 mA for the chain; +5V budget ~570 mA, well inside the TPS62933F (3 A) and L201 (I_sat 3.2 A). LED V_IH is 0.55 VDD = 2.75 V at 5 V; a 3.3 V GPIO gives only 0.15 V margin, so U804 (TTL input, 5 V output) drives the chain. WS2812 protocol, GRB order,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
ST25DV04KC: ISO 15693 / NFC Type 5 tag on I2C3 (0x53 user, 0x57 system); V_EH unused; GPO open drain -> PA2 (EXTI2). AE801: 10 turns, 25 x 21 mm, 4.25 uH; f0 14.2 MHz with C_TUN 28.5 pF + 1 pF (scripts/nfc_coil.py, docs/nfc.md). C804 2.7 pF DNP across AC0-AC1 trims f0 to 13.56 MHz: fit after a phon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
Qwiic I2C3 expansion and EEPROM (PB10 SCL, PB11 SDA)

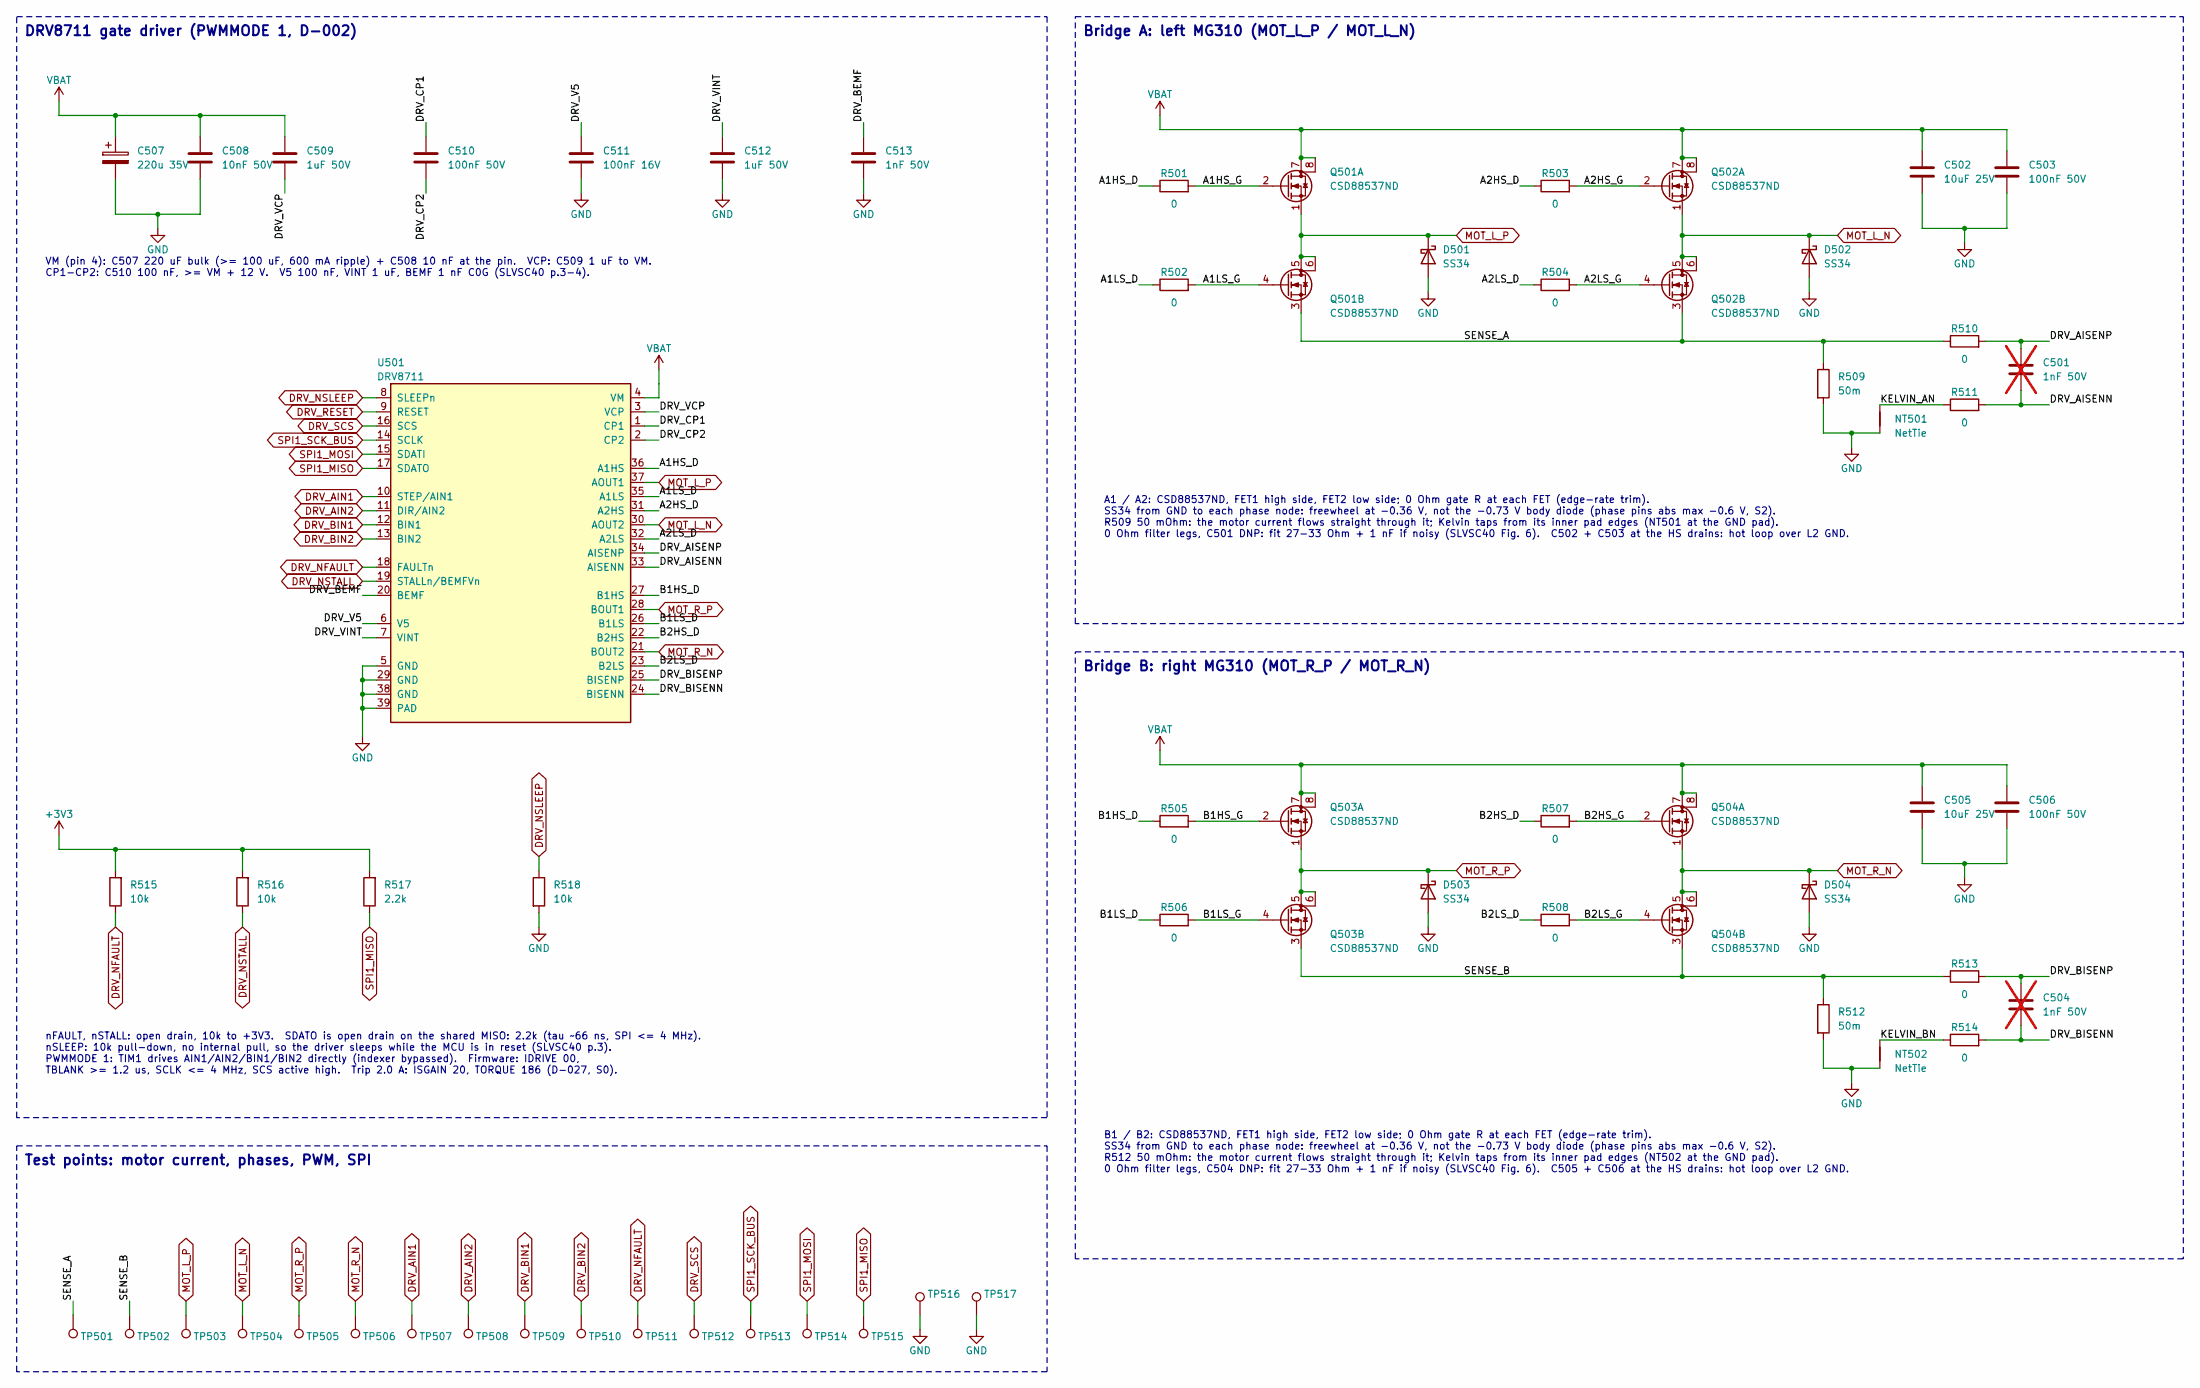
[picture p23: schematic drive.kicad_sch, 5 Motor drive (DRV8711 + external FETs)]

Parts:
C501, C504: 1nF 50V; C_0402_1005Metric; MPN CL05C102JB5NNNC; LCSC C307441; not fitted
C502, C505: 10uF 25V; C_0805_2012Metric; MPN CL21A106KAYNNNE; LCSC C15850
C503, C506, C510: 100nF 50V; C_0603_1608Metric; MPN CC0603KRX7R9BB104; LCSC C14663
C507: 220u 35V; CP_Elec_8x10; MPN EEEFK1V221P; LCSC C178562
C508: 10nF 50V; C_0603_1608Metric; MPN CL10B103KB8NNNC; LCSC C1589
C509, C512: 1uF 50V; C_0603_1608Metric; MPN CL10A105KB8NNNC; LCSC C15849
C511: 100nF 16V; C_0402_1005Metric; MPN CL05B104KO5NNNC; LCSC C1525
C513: 1nF 50V; C_0402_1005Metric; MPN CL05C102JB5NNNC; LCSC C307441
D501, D502, D503, D504: SS34; D_SMA; MPN SS34; LCSC C8678
NT501, NT502: NetTie; NetTie-2_SMD_Pad0.5mm
Q501, Q502, Q503, Q504: CSD88537ND; SOIC-8_3.9x4.9mm_P1.27mm; MPN CSD88537ND; LCSC C117439
R501, R502, R503, R504, R505, R506, R507, R508, R510, R511, R513, R514: 0; R_0603_1608Metric; MPN 0603WAF0000T5E; LCSC C21189
R509, R512: 50m; R_1206_3216Metric; MPN HoLR1206-1W-50mR-1%-75ppm; LCSC C601102
R515, R516, R518: 10k; R_0603_1608Metric; MPN 0603WAF1002T5E; LCSC C25804
R517: 2.2k; R_0603_1608Metric; MPN 0603WAF2201T5E; LCSC C4190
TP501: SENSE_A; TestPoint_Pad_D1.0mm
TP502: SENSE_B; TestPoint_Pad_D1.0mm
TP503: MOT_L_P; TestPoint_Pad_D1.0mm
TP504: MOT_L_N; TestPoint_Pad_D1.0mm
TP505: MOT_R_P; TestPoint_Pad_D1.0mm
TP506: MOT_R_N; TestPoint_Pad_D1.0mm
TP507: DRV_AIN1; TestPoint_Pad_D1.0mm
TP508: DRV_AIN2; TestPoint_Pad_D1.0mm
TP509: DRV_BIN1; TestPoint_Pad_D1.0mm
TP510: DRV_BIN2; TestPoint_Pad_D1.0mm
TP511: DRV_NFAULT; TestPoint_Pad_D1.0mm
TP512: DRV_SCS; TestPoint_Pad_D1.0mm
TP513: SPI1_SCK_BUS; TestPoint_Pad_D1.0mm
TP514: SPI1_MOSI; TestPoint_Pad_D1.0mm
TP515: SPI1_MISO; TestPoint_Pad_D1.0mm
TP516, TP517: GND; TestPoint_Pad_D1.5mm
U501: DRV8711; HTSSOP-38-1EP_4.4x9.7mm_P0.5mm_EP2.74x4.75mm_ThermalVias; MPN DRV8711DCPR; LCSC C60013

Connections:
+3V3: R515.2, R516.2, R517.2; also elsewhere on the board
/5 Motor drive (DRV8711 + external FETs)/A1HS_D: R501.1, U501.36 (A1HS)
/5 Motor drive (DRV8711 + external FETs)/A1HS_G: Q501.2 (G), R501.2
/5 Motor drive (DRV8711 + external FETs)/A1LS_D: R502.1, U501.35 (A1LS)
/5 Motor drive (DRV8711 + external FETs)/A1LS_G: Q501.4 (G), R502.2
/5 Motor drive (DRV8711 + external FETs)/A2HS_D: R503.1, U501.31 (A2HS)
/5 Motor drive (DRV8711 + external FETs)/A2HS_G: Q502.2 (G), R503.2
/5 Motor drive (DRV8711 + external FETs)/A2LS_D: R504.1, U501.32 (A2LS)
/5 Motor drive (DRV8711 + external FETs)/A2LS_G: Q502.4 (G), R504.2
/5 Motor drive (DRV8711 + external FETs)/B1HS_D: R505.1, U501.27 (B1HS)
/5 Motor drive (DRV8711 + external FETs)/B1HS_G: Q503.2 (G), R505.2
/5 Motor drive (DRV8711 + external FETs)/B1LS_D: R506.1, U501.26 (B1LS)
/5 Motor drive (DRV8711 + external FETs)/B1LS_G: Q503.4 (G), R506.2
/5 Motor drive (DRV8711 + external FETs)/B2HS_D: R507.1, U501.22 (B2HS)
/5 Motor drive (DRV8711 + external FETs)/B2HS_G: Q504.2 (G), R507.2
/5 Motor drive (DRV8711 + external FETs)/B2LS_D: R508.1, U501.23 (B2LS)
/5 Motor drive (DRV8711 + external FETs)/B2LS_G: Q504.4 (G), R508.2
/5 Motor drive (DRV8711 + external FETs)/DRV_AISENN: C501.2, R511.2, U501.33 (AISENN)
/5 Motor drive (DRV8711 + external FETs)/DRV_AISENP: C501.1, R510.2, U501.34 (AISENP)
/5 Motor drive (DRV8711 + external FETs)/DRV_BEMF: C513.1, U501.20 (BEMF)
/5 Motor drive (DRV8711 + external FETs)/DRV_BISENN: C504.2, R514.2, U501.24 (BISENN)
/5 Motor drive (DRV8711 + external FETs)/DRV_BISENP: C504.1, R513.2, U501.25 (BISENP)
/5 Motor drive (DRV8711 + external FETs)/DRV_CP1: C510.1, U501.1 (CP1)
/5 Motor drive (DRV8711 + external FETs)/DRV_CP2: C510.2, U501.2 (CP2)
/5 Motor drive (DRV8711 + external FETs)/DRV_V5: C511.1, U501.6 (V5)
/5 Motor drive (DRV8711 + external FETs)/DRV_VCP: C509.1, U501.3 (VCP)
/5 Motor drive (DRV8711 + external FETs)/DRV_VINT: C512.1, U501.7 (VINT)
/5 Motor drive (DRV8711 + external FETs)/KELVIN_AN: NT501.1, R511.1
/5 Motor drive (DRV8711 + external FETs)/KELVIN_BN: NT502.1, R514.1
/5 Motor drive (DRV8711 + external FETs)/SENSE_A: Q501.3 (S), Q502.3 (S), R509.1, R510.1, TP501.1
/5 Motor drive (DRV8711 + external FETs)/SENSE_B: Q503.3 (S), Q504.3 (S), R512.1, R513.1, TP502.1
DRV_AIN1: TP507.1, U501.10 (STEP/AIN1); also elsewhere on the board
DRV_AIN2: TP508.1, U501.11 (DIR/AIN2); also elsewhere on the board
DRV_BIN1: TP509.1, U501.12 (BIN1); also elsewhere on the board
DRV_BIN2: TP510.1, U501.13 (BIN2); also elsewhere on the board
DRV_NFAULT: R515.1, TP511.1, U501.18 (FAULTn); also elsewhere on the board
DRV_NSLEEP: R518.1, U501.8 (SLEEPn); also elsewhere on the board
DRV_NSTALL: R516.1, U501.19 (STALLn/BEMFVn); also elsewhere on the board
DRV_RESET: U501.9 (RESET); also elsewhere on the board
DRV_SCS: TP512.1, U501.16 (SCS); also elsewhere on the board
GND: C502.2, C503.2, C505.2, C506.2, C507.2, C508.2, C511.2, C512.2, C513.2, D501.2 (A), D502.2 (A), D503.2 (A), D504.2 (A), NT501.2, NT502.2, R509.2, R512.2, R518.2, TP516.1, TP517.1, U501.5 (GND), U501.29 (GND), U501.38 (GND), U501.39 (PAD); also elsewhere on the board
MOT_L_N: D502.1 (K), Q502.1 (S), Q502.5 (D), Q502.6 (D), TP504.1, U501.30 (AOUT2); also elsewhere on the board
MOT_L_P: D501.1 (K), Q501.1 (S), Q501.5 (D), Q501.6 (D), TP503.1, U501.37 (AOUT1); also elsewhere on the board
MOT_R_N: D504.1 (K), Q504.1 (S), Q504.5 (D), Q504.6 (D), TP506.1, U501.21 (BOUT2); also elsewhere on the board
MOT_R_P: D503.1 (K), Q503.1 (S), Q503.5 (D), Q503.6 (D), TP505.1, U501.28 (BOUT1); also elsewhere on the board
SPI1_MISO: R517.1, TP515.1, U501.17 (SDATO); also elsewhere on the board
SPI1_MOSI: TP514.1, U501.15 (SDATI); also elsewhere on the board
SPI1_SCK_BUS: TP513.1, U501.14 (SCLK); also elsewhere on the board
VBAT: C502.1, C503.1, C505.1, C506.1, C507.1, C508.1, C509.2, Q501.7 (D), Q501.8 (D), Q502.7 (D), Q502.8 (D), Q503.7 (D), Q503.8 (D), Q504.7 (D), Q504.8 (D), U501.4 (VM); also elsewhere on the board

Notes on the sheet:
B1 / B2: CSD88537ND, FET1 high side, FET2 low side; 0 Ohm gate R at each FET (edge-rate trim). SS34 from GND to each phase node: freewheel at -0.36 V, not the -0.73 V body diode (phase pins abs max -0.6 V, S2). R512 50 mOhm: the motor current flows straight through it; Kelvin taps from its inner pa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
Test points: motor current, phases, PWM, SPI
Bridge B: right MG310 (MOT_R_P / MOT_R_N)
VM (pin 4): C507 220 uF bulk (>= 100 uF, 600 mA ripple) + C508 10 nF at the pin. VCP: C509 1 uF to VM. CP1-CP2: C510 100 nF, >= VM + 12 V. V5 100 nF, VINT 1 uF, BEMF 1 nF C0G (SLVSC40 p.3-4).
DRV8711 gate driver (PWMMODE 1, D-002)
nFAULT, nSTALL: open drain, 10k to +3V3. SDATO is open drain on the shared MISO: 2.2k (tau ~66 ns, SPI <= 4 MHz). nSLEEP: 10k pull-down, no internal pull, so the driver sleeps while the MCU is in reset (SLVSC40 p.3). PWMMODE 1: TIM1 drives AIN1/AIN2/BIN1/BIN2 directly (indexer bypassed). Firmware: 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
A1 / A2: CSD88537ND, FET1 high side, FET2 low side; 0 Ohm gate R at each FET (edge-rate trim). SS34 from GND to each phase node: freewheel at -0.36 V, not the -0.73 V body diode (phase pins abs max -0.6 V, S2). R509 50 mOhm: the motor current flows straight through it; Kelvin taps from its inner pa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
Bridge A: left MG310 (MOT_L_P / MOT_L_N)

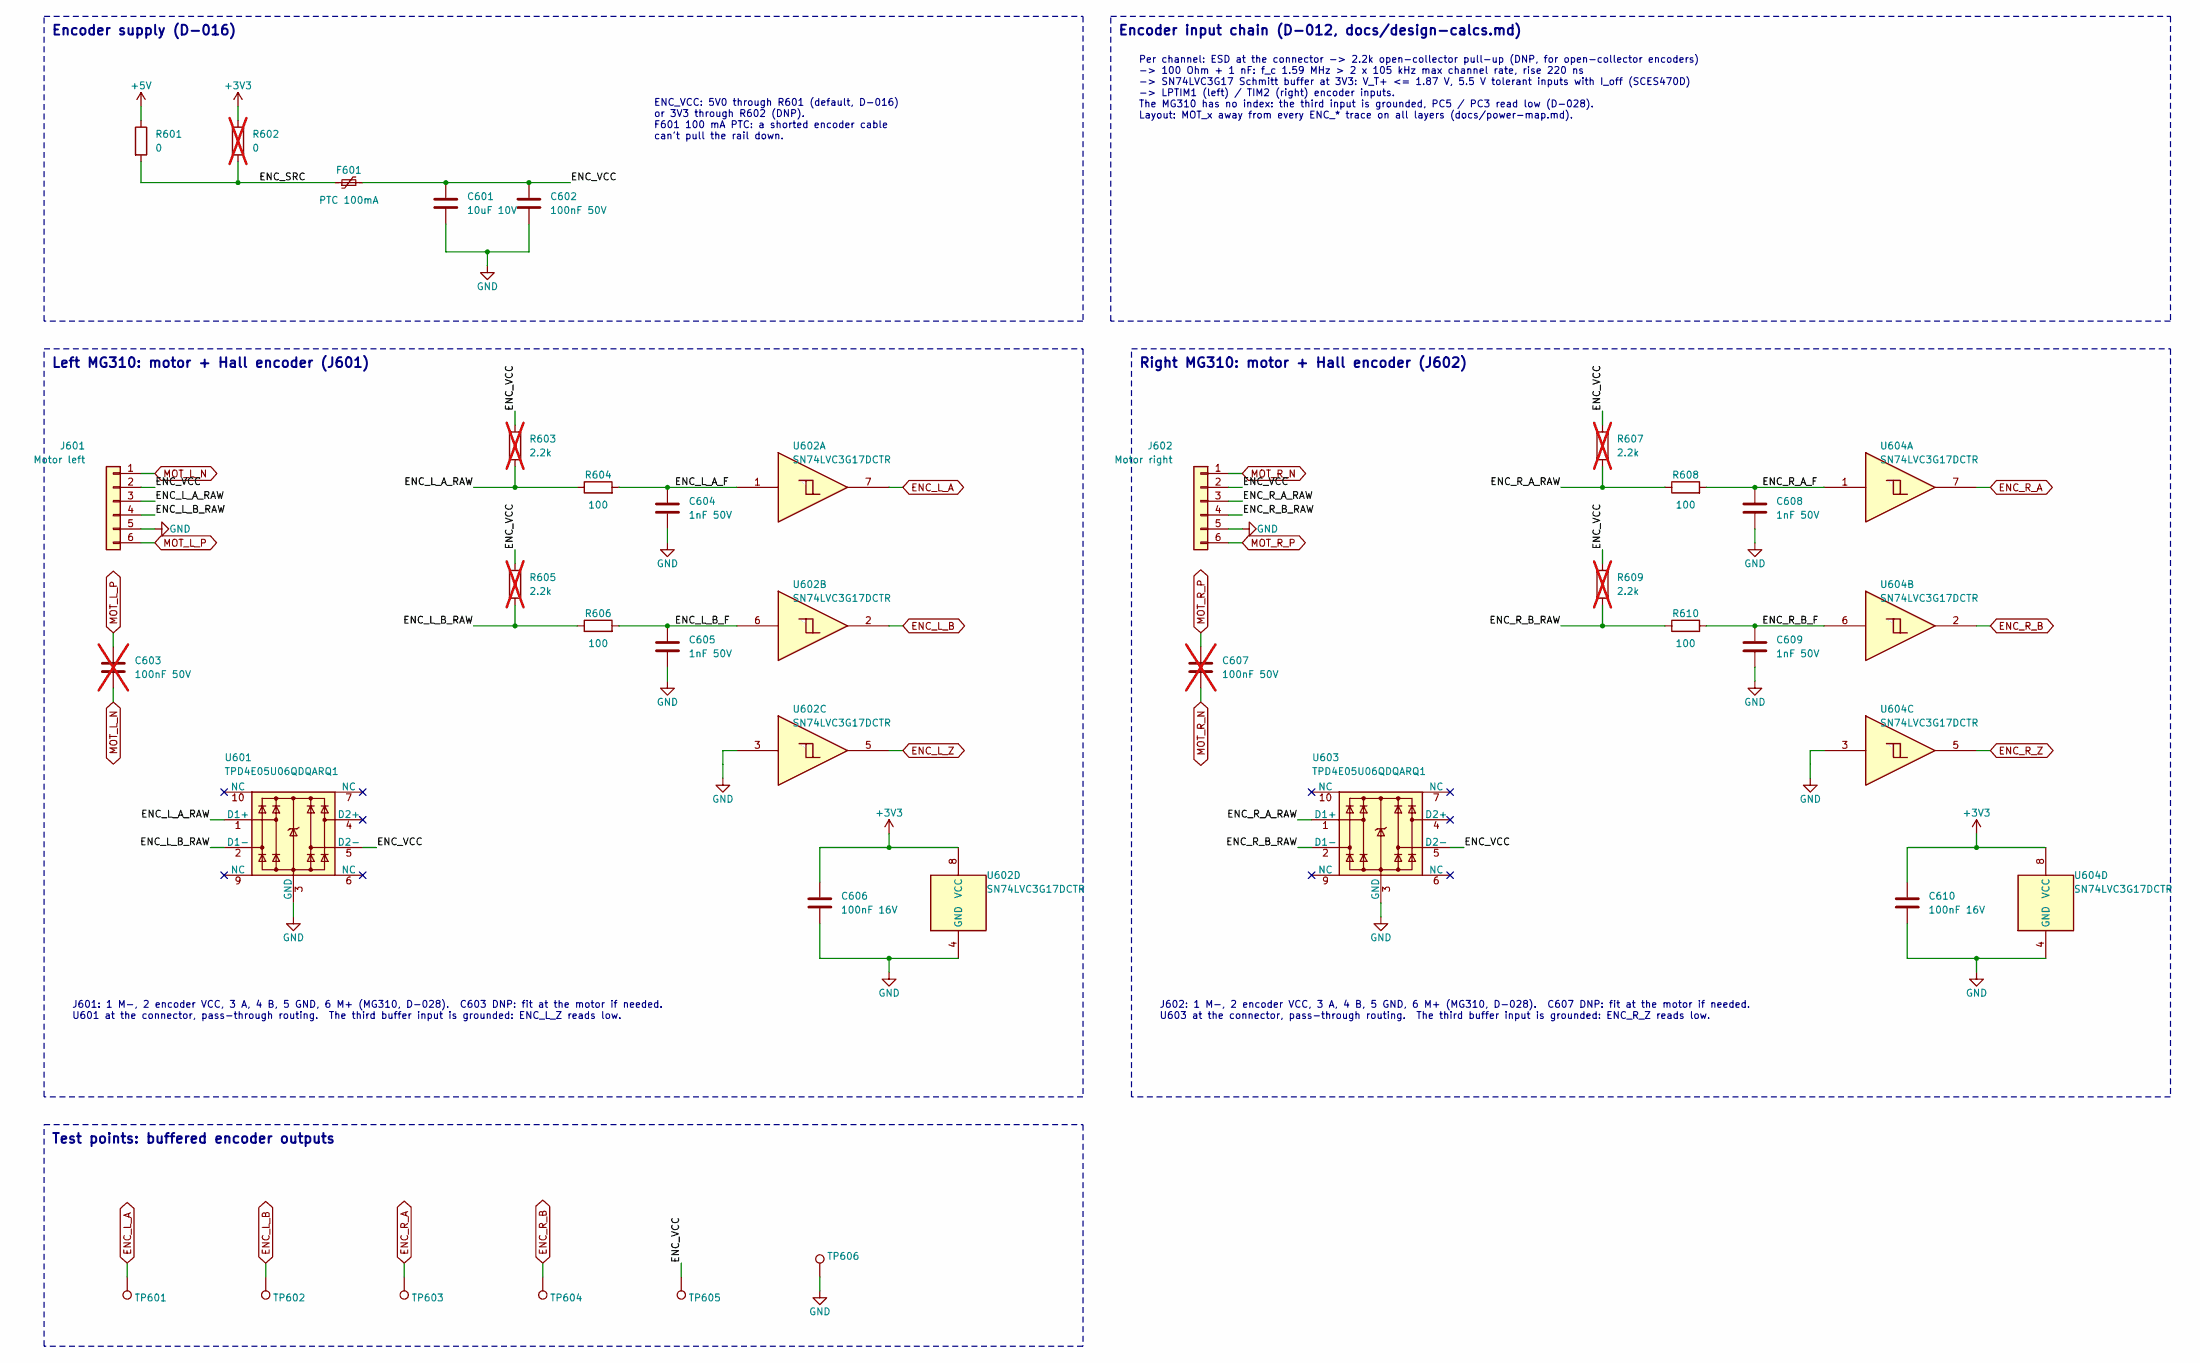
[picture p24: schematic motors_encoders.kicad_sch, 6 Motor connectors and encoder inputs]

Parts:
C601: 10uF 10V; C_0603_1608Metric; MPN CL10A106KP8NNNC; LCSC C19702
C602: 100nF 50V; C_0603_1608Metric; MPN CC0603KRX7R9BB104; LCSC C14663
C603, C607: 100nF 50V; C_0603_1608Metric; MPN CC0603KRX7R9BB104; LCSC C14663; not fitted
C604, C605, C608, C609: 1nF 50V; C_0603_1608Metric; MPN CL10B102KB8NNNC; LCSC C1588
C606, C610: 100nF 16V; C_0402_1005Metric; MPN CL05B104KO5NNNC; LCSC C1525
F601: PTC 100mA; Fuse_0805_2012Metric; MPN SMD0805P010TF; LCSC C20975
J601: Motor left; JST_PH_S6B-PH-K_1x06_P2.00mm_Horizontal; MPN S6B-PH-K-S(LF)(SN); LCSC C157920
J602: Motor right; JST_PH_S6B-PH-K_1x06_P2.00mm_Horizontal; MPN S6B-PH-K-S(LF)(SN); LCSC C157920
R601: 0; R_0603_1608Metric; MPN 0603WAF0000T5E; LCSC C21189
R602: 0; R_0603_1608Metric; MPN 0603WAF0000T5E; LCSC C21189; not fitted
R603, R605, R607, R609: 2.2k; R_0603_1608Metric; MPN 0603WAF2201T5E; LCSC C4190; not fitted
R604, R606, R608, R610: 100; R_0603_1608Metric; MPN 0603WAF1000T5E; LCSC C22775
TP601: ENC_L_A; TestPoint_Pad_D1.0mm
TP602: ENC_L_B; TestPoint_Pad_D1.0mm
TP603: ENC_R_A; TestPoint_Pad_D1.0mm
TP604: ENC_R_B; TestPoint_Pad_D1.0mm
TP605: ENC_VCC; TestPoint_Pad_D1.5mm
TP606: GND; TestPoint_Pad_D1.5mm
U601, U603: TPD4E05U06QDQARQ1; USON-10_2.5x1.0mm_P0.5mm; MPN TPD4E05U06QDQARQ1; LCSC C81353
U602, U604: SN74LVC3G17DCTR; SSOP-8_2.95x2.8mm_P0.65mm; MPN SN74LVC3G17DCTR; LCSC C18213

Connections:
+3V3: C606.1, C610.1, R602.1, U602.8 (VCC), U604.8 (VCC); also elsewhere on the board
+5V: R601.1; also elsewhere on the board
/6 Motor connectors and encoder inputs/ENC_L_A_F: C604.1, R604.2, U602.1
/6 Motor connectors and encoder inputs/ENC_L_A_RAW: J601.3, R603.1, R604.1, U601.1 (D1+)
/6 Motor connectors and encoder inputs/ENC_L_B_F: C605.1, R606.2, U602.6
/6 Motor connectors and encoder inputs/ENC_L_B_RAW: J601.4, R605.1, R606.1, U601.2 (D1-)
/6 Motor connectors and encoder inputs/ENC_R_A_F: C608.1, R608.2, U604.1
/6 Motor connectors and encoder inputs/ENC_R_A_RAW: J602.3, R607.1, R608.1, U603.1 (D1+)
/6 Motor connectors and encoder inputs/ENC_R_B_F: C609.1, R610.2, U604.6
/6 Motor connectors and encoder inputs/ENC_R_B_RAW: J602.4, R609.1, R610.1, U603.2 (D1-)
/6 Motor connectors and encoder inputs/ENC_SRC: F601.1, R601.2, R602.2
/6 Motor connectors and encoder inputs/ENC_VCC: C601.1, C602.1, F601.2, J601.2, J602.2, R603.2, R605.2, R607.2, R609.2, TP605.1, U601.5 (D2-), U603.5 (D2-)
ENC_L_A: TP601.1, U602.7; also elsewhere on the board
ENC_L_B: TP602.1, U602.2; also elsewhere on the board
ENC_L_Z: U602.5; also elsewhere on the board
ENC_R_A: TP603.1, U604.7; also elsewhere on the board
ENC_R_B: TP604.1, U604.2; also elsewhere on the board
ENC_R_Z: U604.5; also elsewhere on the board
GND: C601.2, C602.2, C604.2, C605.2, C606.2, C608.2, C609.2, C610.2, J601.5, J602.5, TP606.1, U601.3 (GND), U601.8 (GND), U602.3, U602.4 (GND), U603.3 (GND), U603.8 (GND), U604.3, U604.4 (GND); also elsewhere on the board
MOT_L_N: C603.2, J601.1; also elsewhere on the board
MOT_L_P: C603.1, J601.6; also elsewhere on the board
MOT_R_N: C607.2, J602.1; also elsewhere on the board
MOT_R_P: C607.1, J602.6; also elsewhere on the board

Notes on the sheet:
Per channel: ESD at the connector -> 2.2k open-collector pull-up (DNP, for open-collector encoders) -> 100 Ohm + 1 nF: f_c 1.59 MHz > 2 x 105 kHz max channel rate, rise 220 ns -> SN74LVC3G17 Schmitt buffer at 3V3: V_T+ <= 1.87 V, 5.5 V tolerant inputs with I_off (SCES470D) -> LPTIM1 (left) / TIM2 (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
Right MG310: motor + Hall encoder (J602)
J602: 1 M-, 2 encoder VCC, 3 A, 4 B, 5 GND, 6 M+ (MG310, D-028). C607 DNP: fit at the motor if needed. U603 at the connector, pass-through routing. The third buffer input is grounded: ENC_R_Z reads low.
J601: 1 M-, 2 encoder VCC, 3 A, 4 B, 5 GND, 6 M+ (MG310, D-028). C603 DNP: fit at the motor if needed. U601 at the connector, pass-through routing. The third buffer input is grounded: ENC_L_Z reads low.
Encoder input chain (D-012, docs/design-calcs.md)
ENC_VCC: 5V0 through R601 (default, D-016) or 3V3 through R602 (DNP). F601 100 mA PTC: a shorted encoder cable can't pull the rail down.
Left MG310: motor + Hall encoder (J601)
Test points: buffered encoder outputs
Encoder supply (D-016)
