embedded-pro/e-inverted-pendulum-hardware/hardware/e-inverted-pendulum/e-inverted-pendulum.kicad_pcb

## KiCad design hardware/e-inverted-pendulum/e-inverted-pendulum.kicad_pcb (continued)

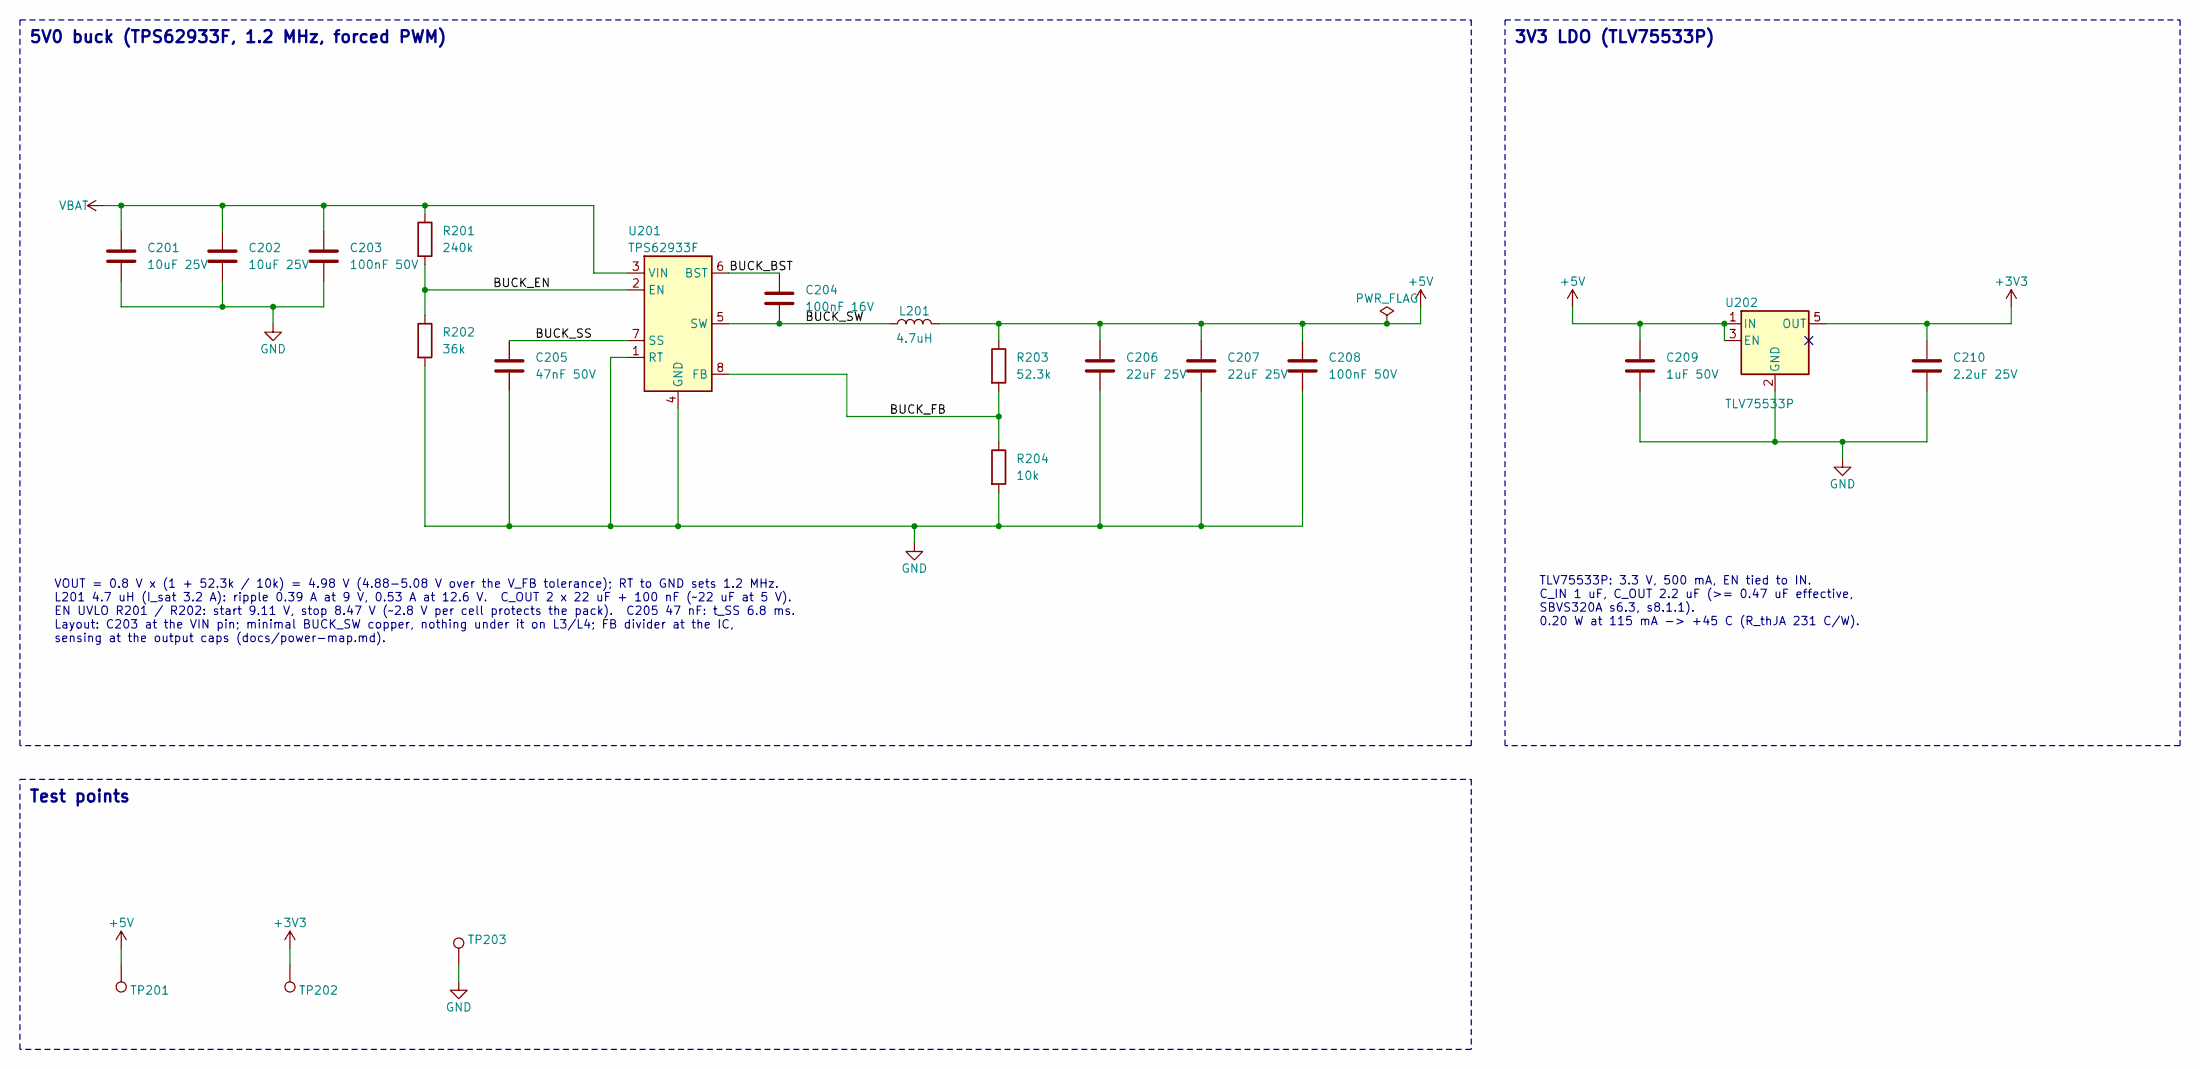
[picture p25: schematic logic_power.kicad_sch, 2 5V0 buck and 3V3 LDO]

Parts:
C201, C202: 10uF 25V; C_0805_2012Metric; MPN CL21A106KAYNNNE; LCSC C15850
C203, C208: 100nF 50V; C_0603_1608Metric; MPN CC0603KRX7R9BB104; LCSC C14663
C204: 100nF 16V; C_0402_1005Metric; MPN CL05B104KO5NNNC; LCSC C1525
C205: 47nF 50V; C_0603_1608Metric; MPN CL10B473KB8NNNC; LCSC C1622
C206, C207: 22uF 25V; C_0805_2012Metric; MPN CL21A226MAQNNNE; LCSC C45783
C209: 1uF 50V; C_0603_1608Metric; MPN CL10A105KB8NNNC; LCSC C15849
C210: 2.2uF 25V; C_0603_1608Metric; MPN CL10A225KO8NNNC; LCSC C23630
L201: 4.7uH; L_Sunlord_SWPA4030S; MPN SWPA4030S4R7MT; LCSC C57269
R201: 240k; R_0603_1608Metric; MPN 0603WAF2403T5E; LCSC C4197
R202: 36k; R_0603_1608Metric; MPN 0603WAF3602T5E; LCSC C23147
R203: 52.3k; R_0603_1608Metric; MPN 0603WAF5232T5E; LCSC C23198
R204: 10k; R_0603_1608Metric; MPN 0603WAF1002T5E; LCSC C25804
TP201: +5V; TestPoint_Pad_D1.5mm
TP202: +3V3; TestPoint_Pad_D1.5mm
TP203: GND; TestPoint_Pad_D1.5mm
U201: TPS62933F; SOT-583-8; MPN TPS62933FDRLR; LCSC C5219272
U202: TLV75533P; SOT-23-5; MPN TLV75533PDBVR; LCSC C404027

Connections:
+3V3: C210.1, TP202.1, U202.5 (OUT); also elsewhere on the board
+5V: C206.1, C207.1, C208.1, C209.1, L201.2, R203.1, TP201.1, U202.1 (IN), U202.3 (EN); also elsewhere on the board
/2 5V0 buck and 3V3 LDO/BUCK_BST: C204.1, U201.6 (BST)
/2 5V0 buck and 3V3 LDO/BUCK_EN: R201.2, R202.1, U201.2 (EN)
/2 5V0 buck and 3V3 LDO/BUCK_FB: R203.2, R204.1, U201.8 (FB)
/2 5V0 buck and 3V3 LDO/BUCK_SS: C205.1, U201.7 (SS)
/2 5V0 buck and 3V3 LDO/BUCK_SW: C204.2, L201.1, U201.5 (SW)
GND: C201.2, C202.2, C203.2, C205.2, C206.2, C207.2, C208.2, C209.2, C210.2, R202.2, R204.2, TP203.1, U201.1 (RT), U201.4 (GND), U202.2 (GND); also elsewhere on the board
VBAT: C201.1, C202.1, C203.1, R201.1, U201.3 (VIN); also elsewhere on the board

Notes on the sheet:
VOUT = 0.8 V x (1 + 52.3k / 10k) = 4.98 V (4.88-5.08 V over the V_FB tolerance); RT to GND sets 1.2 MHz. L201 4.7 uH (I_sat 3.2 A): ripple 0.39 A at 9 V, 0.53 A at 12.6 V. C_OUT 2 x 22 uF + 100 nF (~22 uF at 5 V). EN UVLO R201 / R202: start 9.11 V, stop 8.47 V (~2.8 V per cell protects the pack). C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
3V3 LDO (TLV75533P)
TLV75533P: 3.3 V, 500 mA, EN tied to IN. C_IN 1 uF, C_OUT 2.2 uF (>= 0.47 uF effective, SBVS320A s6.3, s8.1.1). 0.20 W at 115 mA -> +45 C (R_thJA 231 C/W).
Test points
5V0 buck (TPS62933F, 1.2 MHz, forced PWM)

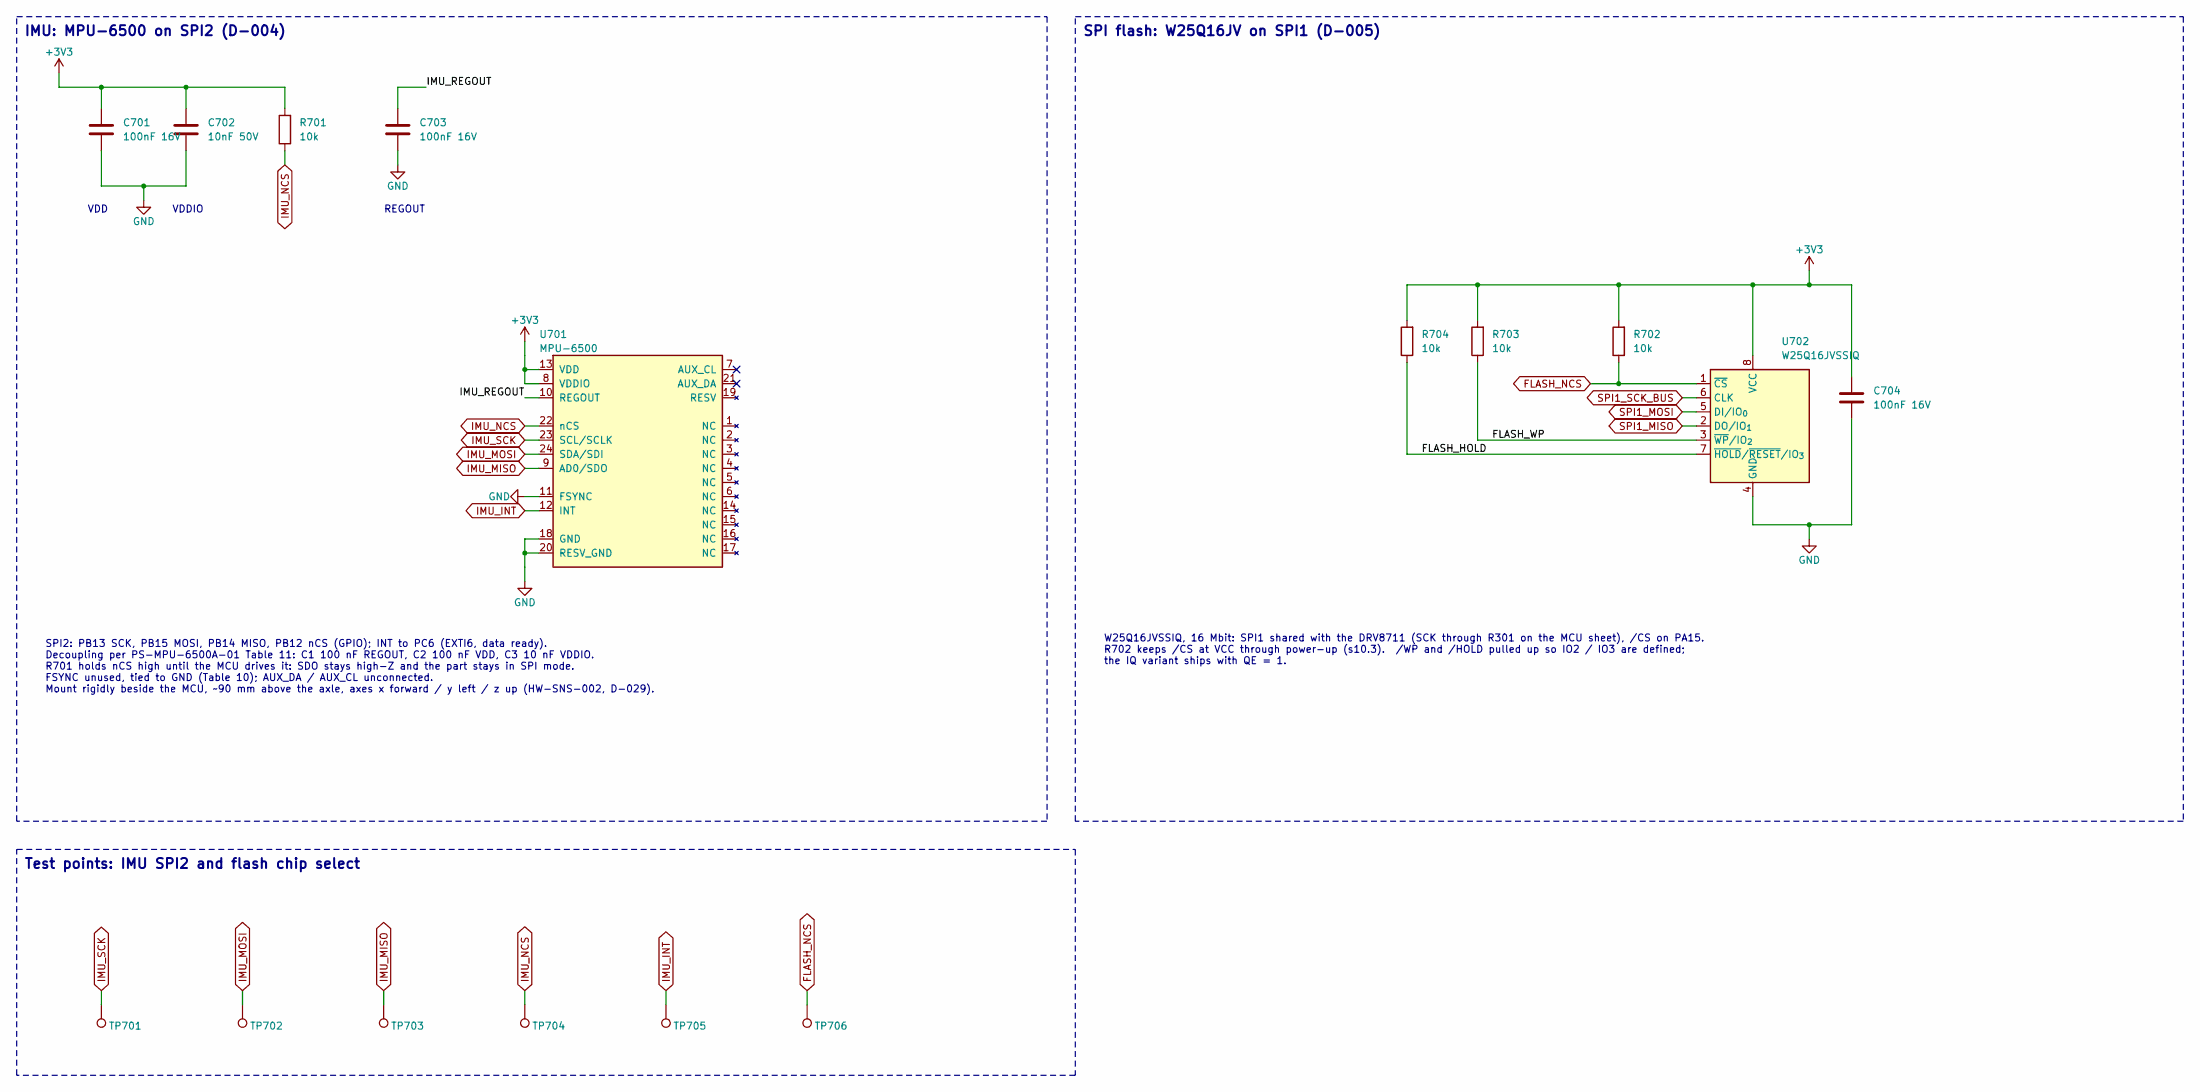
[picture p26: schematic imu_flash.kicad_sch, 7 IMU and SPI flash]

Parts:
C701, C703, C704: 100nF 16V; C_0402_1005Metric; MPN CL05B104KO5NNNC; LCSC C1525
C702: 10nF 50V; C_0603_1608Metric; MPN CL10B103KB8NNNC; LCSC C1589
R701, R702, R703, R704: 10k; R_0603_1608Metric; MPN 0603WAF1002T5E; LCSC C25804
TP701: IMU_SCK; TestPoint_Pad_D1.0mm
TP702: IMU_MOSI; TestPoint_Pad_D1.0mm
TP703: IMU_MISO; TestPoint_Pad_D1.0mm
TP704: IMU_NCS; TestPoint_Pad_D1.0mm
TP705: IMU_INT; TestPoint_Pad_D1.0mm
TP706: FLASH_NCS; TestPoint_Pad_D1.0mm
U701: MPU-6500; InvenSense_QFN-24_3x3mm_P0.4mm; MPN MPU-6500; LCSC C50278
U702: W25Q16JVSSIQ; SOIC-8_5.3x5.3mm_P1.27mm; MPN W25Q16JVSSIQ; LCSC C131025

Connections:
+3V3: C701.1, C702.1, C704.1, R701.2, R702.2, R703.2, R704.2, U701.8 (VDDIO), U701.13 (VDD), U702.8 (VCC); also elsewhere on the board
/7 IMU and SPI flash/FLASH_HOLD: R704.1, U702.7 (~HOLD/~RESET/IO_{3})
/7 IMU and SPI flash/FLASH_WP: R703.1, U702.3 (~WP/IO_{2})
/7 IMU and SPI flash/IMU_REGOUT: C703.1, U701.10 (REGOUT)
FLASH_NCS: R702.1, TP706.1, U702.1 (~CS); also elsewhere on the board
GND: C701.2, C702.2, C703.2, C704.2, U701.11 (FSYNC), U701.18 (GND), U701.20 (RESV_GND), U702.4 (GND); also elsewhere on the board
IMU_INT: TP705.1, U701.12 (INT); also elsewhere on the board
IMU_MISO: TP703.1, U701.9 (AD0/SDO); also elsewhere on the board
IMU_MOSI: TP702.1, U701.24 (SDA/SDI); also elsewhere on the board
IMU_NCS: R701.1, TP704.1, U701.22 (nCS); also elsewhere on the board
IMU_SCK: TP701.1, U701.23 (SCL/SCLK); also elsewhere on the board
SPI1_MISO: U702.2 (DO/IO_{1}); also elsewhere on the board
SPI1_MOSI: U702.5 (DI/IO_{0}); also elsewhere on the board
SPI1_SCK_BUS: U702.6 (CLK); also elsewhere on the board

Notes on the sheet:
VDD
SPI flash: W25Q16JV on SPI1 (D-005)
W25Q16JVSSIQ, 16 Mbit: SPI1 shared with the DRV8711 (SCK through R301 on the MCU sheet), /CS on PA15. R702 keeps /CS at VCC through power-up (s10.3). /WP and /HOLD pulled up so IO2 / IO3 are defined; the IQ variant ships with QE = 1.
REGOUT
SPI2: PB13 SCK, PB15 MOSI, PB14 MISO, PB12 nCS (GPIO); INT to PC6 (EXTI6, data ready). Decoupling per PS-MPU-6500A-01 Table 11: C1 100 nF REGOUT, C2 100 nF VDD, C3 10 nF VDDIO. R701 holds nCS high until the MCU drives it: SDO stays high-Z and the part stays in SPI mode. FSYNC unused, tied to GND (T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
Test points: IMU SPI2 and flash chip select
VDDIO
IMU: MPU-6500 on SPI2 (D-004)

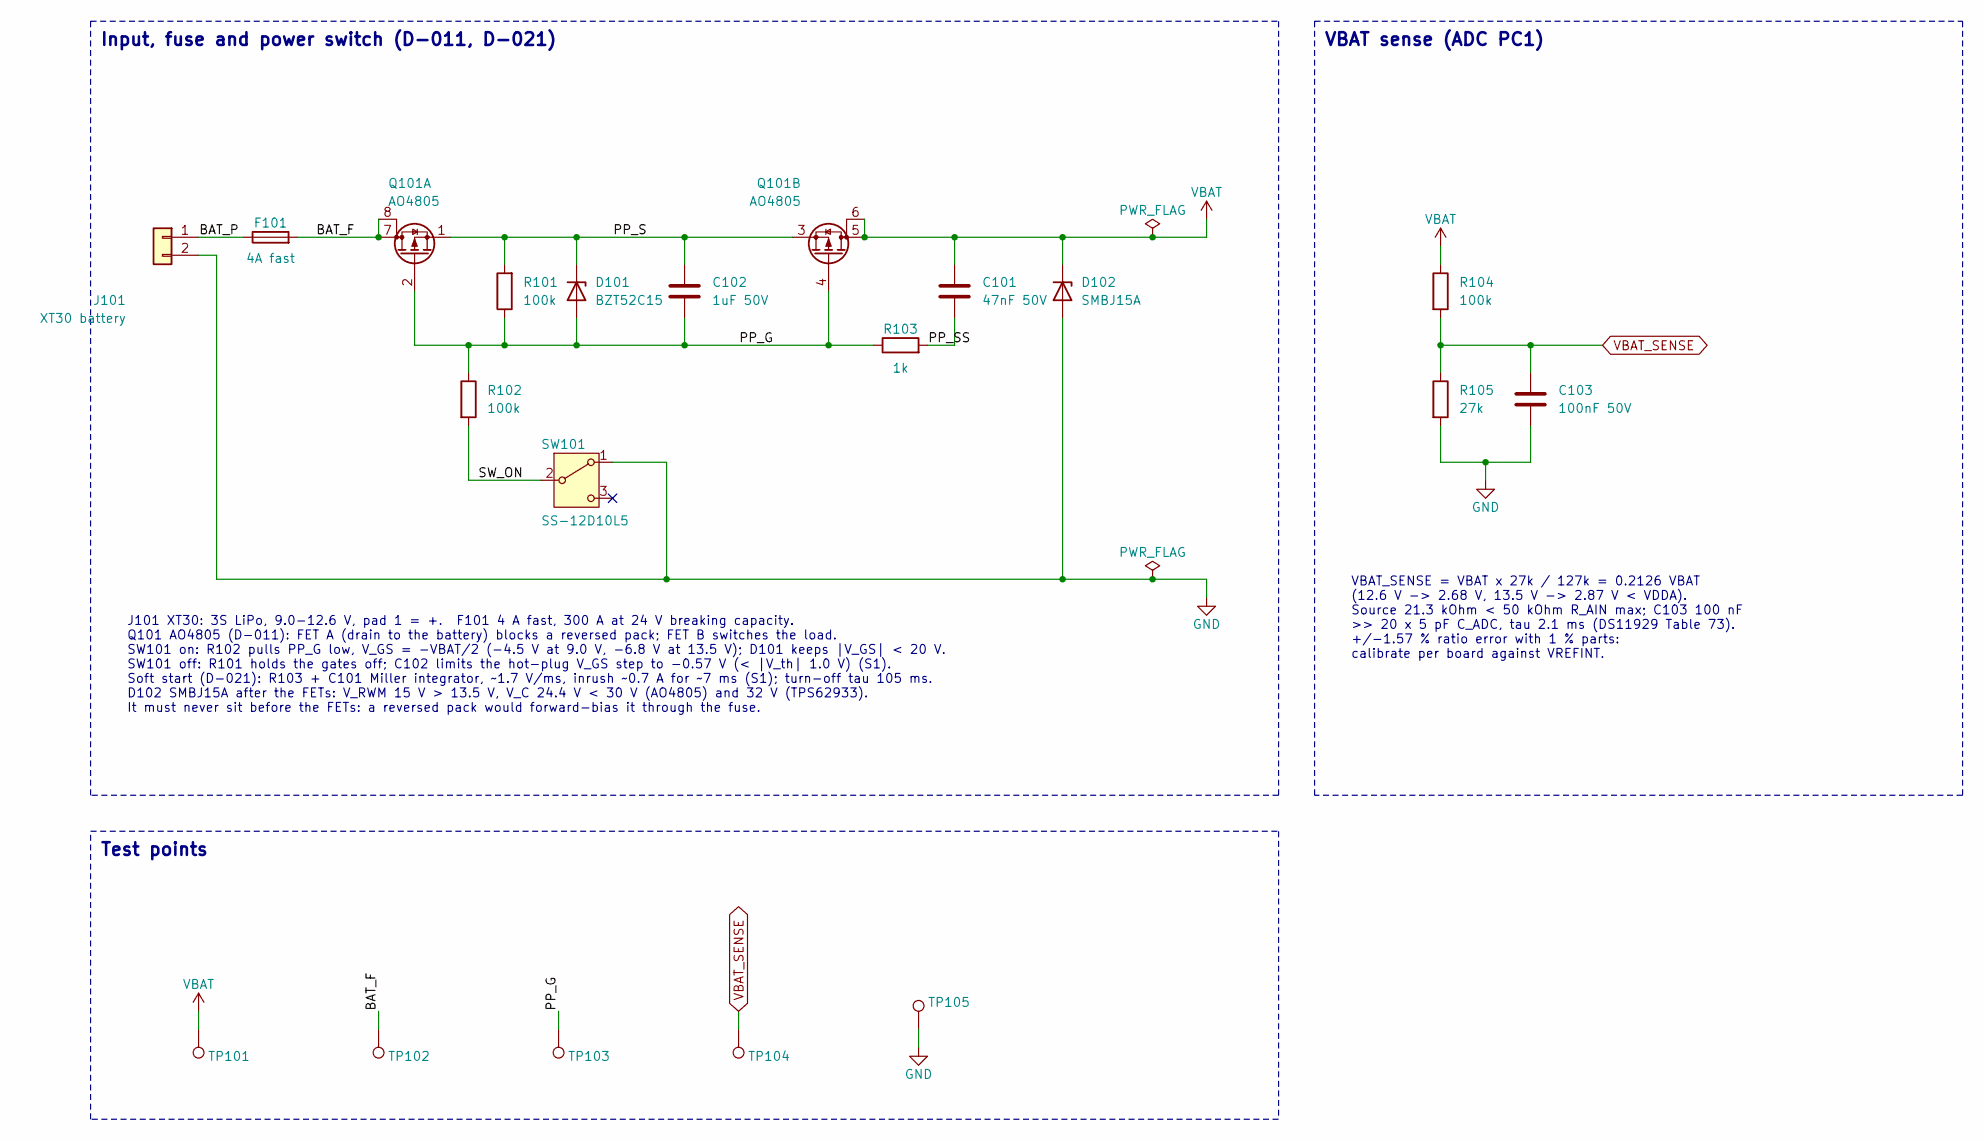
[picture p27: schematic power_entry.kicad_sch, 1 Battery input and protection]

Parts:
C101: 47nF 50V; C_0603_1608Metric; MPN CL10B473KB8NNNC; LCSC C1622
C102: 1uF 50V; C_0603_1608Metric; MPN CL10A105KB8NNNC; LCSC C15849
C103: 100nF 50V; C_0603_1608Metric; MPN CC0603KRX7R9BB104; LCSC C14663
D101: BZT52C15; D_SOD-123; MPN BZT52C15; LCSC C2104
D102: SMBJ15A; D_SMB; MPN SMBJ15A; LCSC C83846
F101: 4A fast; Fuse_1206_3216Metric; MPN 1206FA-4A; LCSC C2937379
J101: XT30 battery; AMASS_XT30UPB-F_1x02_P5.00mm_Vertical; MPN XT30UPB-F30.G.Y; LCSC C108769
Q101: AO4805; SOIC-8_3.9x4.9mm_P1.27mm; MPN AO4805; LCSC C3040596
R101, R102, R104: 100k; R_0603_1608Metric; MPN 0603WAF1003T5E; LCSC C25803
R103: 1k; R_0603_1608Metric; MPN 0603WAF1001T5E; LCSC C21190
R105: 27k; R_0603_1608Metric; MPN 0603WAF2702T5E; LCSC C22967
SW101: SS-12D10L5; SW_Slide_SPDT_SS-12D10L5_P4.70mm; MPN SS-12D10L5; LCSC C319012
TP101: VBAT; TestPoint_Pad_D1.5mm
TP102: BAT_F; TestPoint_Pad_D1.0mm
TP103: PP_G; TestPoint_Pad_D1.0mm
TP104: VBAT_SENSE; TestPoint_Pad_D1.0mm
TP105: GND; TestPoint_Pad_D1.5mm

Connections:
/1 Battery input and protection/BAT_F: F101.2, Q101.7 (D), Q101.8 (D), TP102.1
/1 Battery input and protection/BAT_P: F101.1, J101.1
/1 Battery input and protection/PP_G: C102.1, D101.2 (A), Q101.2 (G), Q101.4 (G), R101.1, R102.1, R103.1, TP103.1
/1 Battery input and protection/PP_S: C102.2, D101.1 (K), Q101.1 (S), Q101.3 (S), R101.2
/1 Battery input and protection/PP_SS: C101.1, R103.2
/1 Battery input and protection/SW_ON: R102.2, SW101.2 (B)
GND: C103.2, D102.2 (A), J101.2, R105.2, SW101.1 (A), TP105.1; also elsewhere on the board
VBAT: C101.2, D102.1 (K), Q101.5 (D), Q101.6 (D), R104.1, TP101.1; also elsewhere on the board
VBAT_SENSE: C103.1, R104.2, R105.1, TP104.1; also elsewhere on the board

Notes on the sheet:
J101 XT30: 3S LiPo, 9.0-12.6 V, pad 1 = +. F101 4 A fast, 300 A at 24 V breaking capacity. Q101 AO4805 (D-011): FET A (drain to the battery) blocks a reversed pack; FET B switches the load. SW101 on: R102 pulls PP_G low, V_GS = -VBAT/2 (-4.5 V at 9.0 V, -6.8 V at 13.5 V); D101 keeps |V_GS| < 20 V. 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
Input, fuse and power switch (D-011, D-021)
VBAT sense (ADC PC1)
VBAT_SENSE = VBAT x 27k / 127k = 0.2126 VBAT (12.6 V -> 2.68 V, 13.5 V -> 2.87 V < VDDA). Source 21.3 kOhm < 50 kOhm R_AIN max; C103 100 nF >> 20 x 5 pF C_ADC, tau 2.1 ms (DS11929 Table 73). +/-1.57 % ratio error with 1 % parts: calibrate per board against VREFINT.
Test points

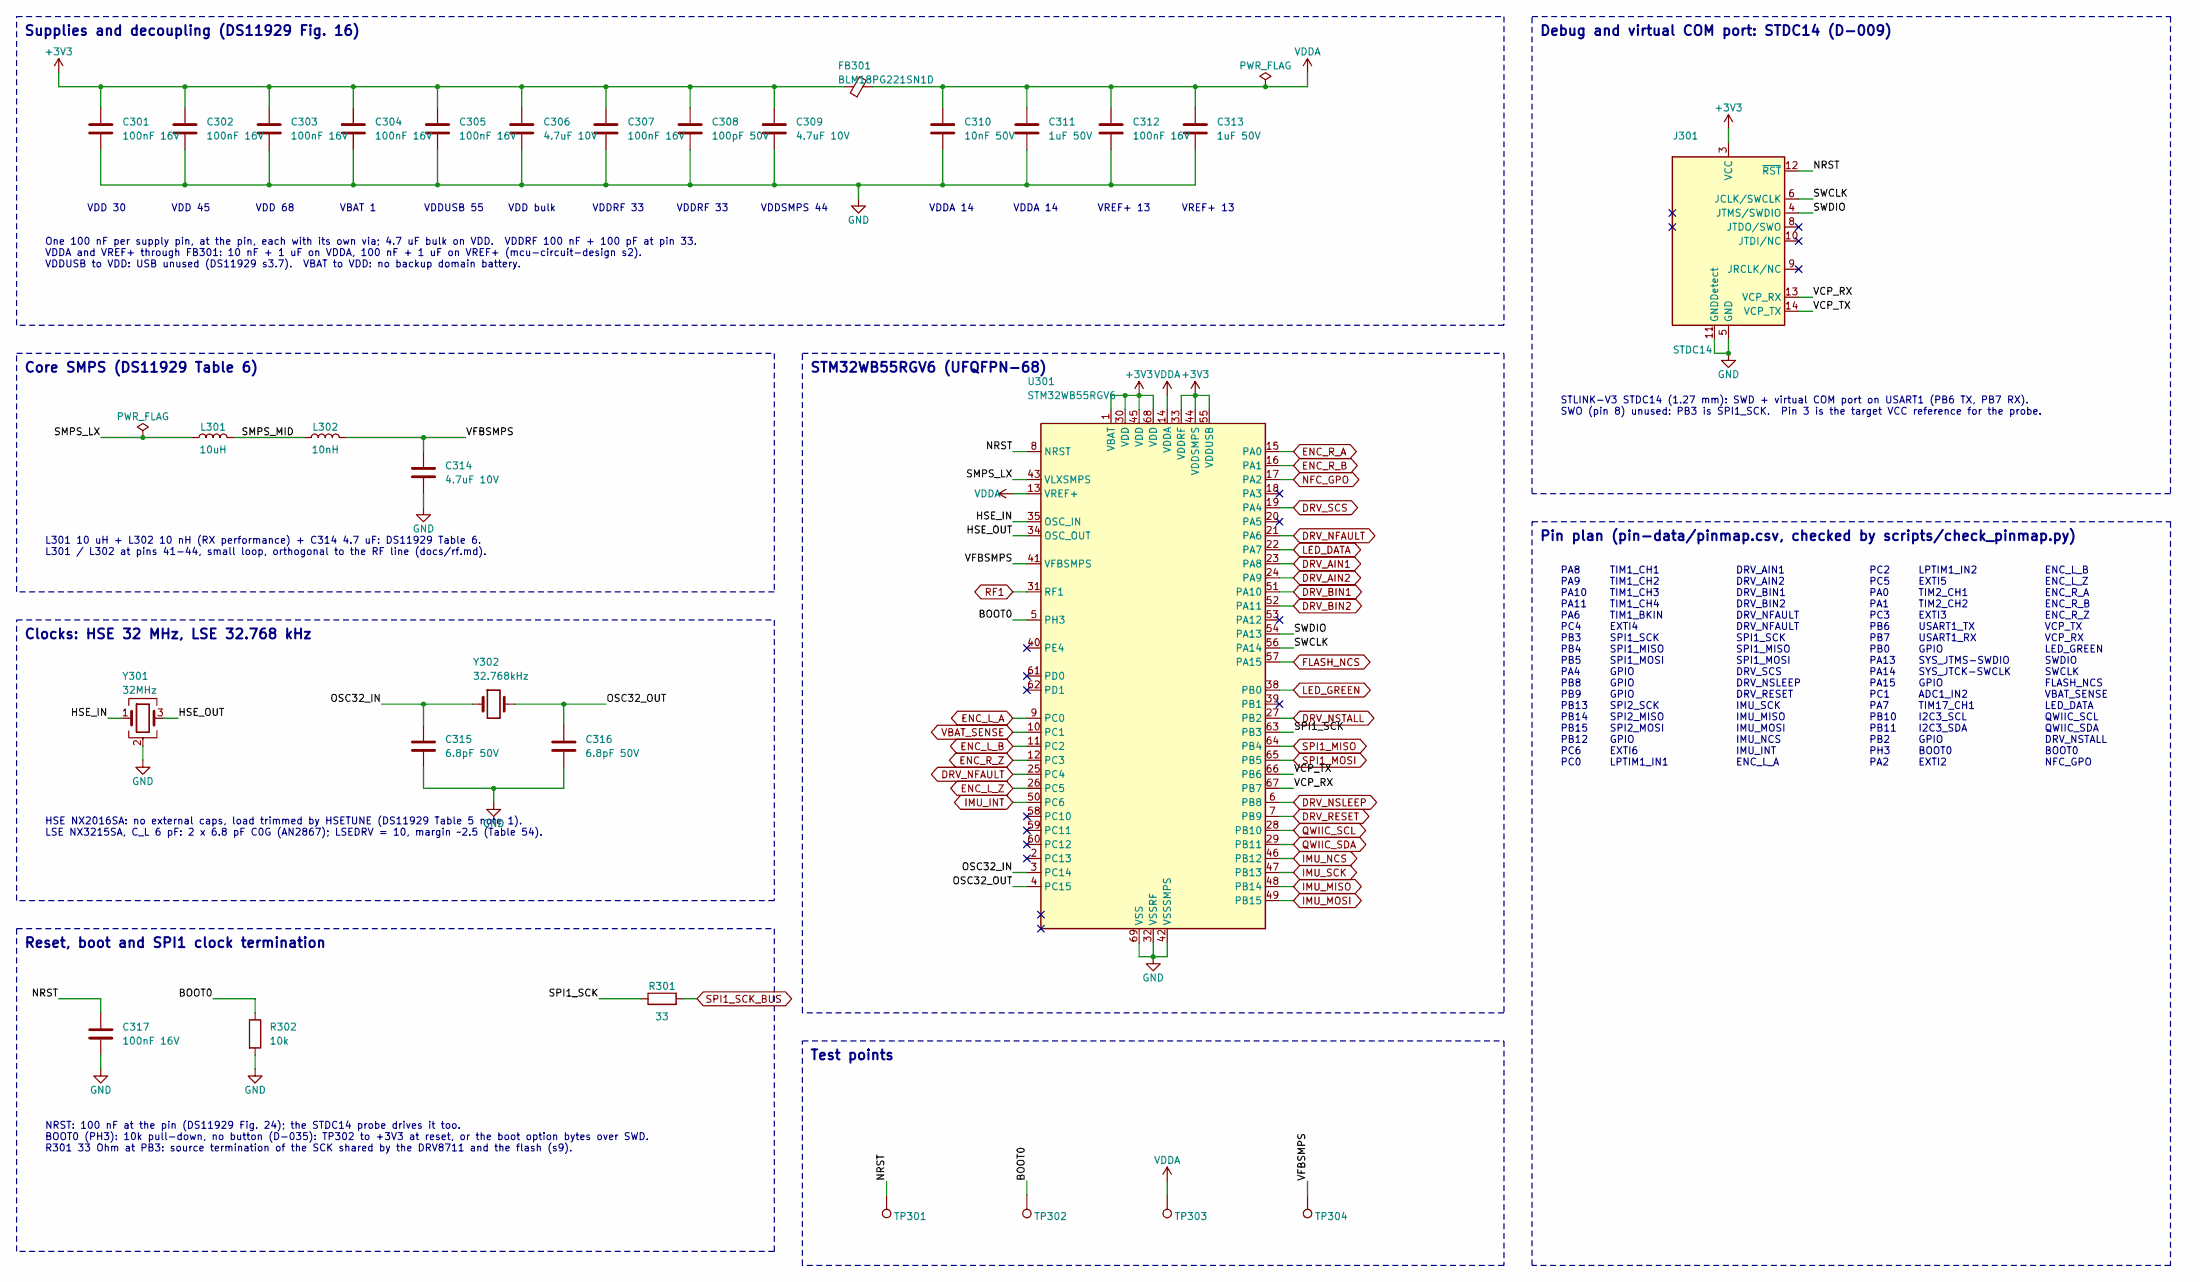
[picture p28: schematic mcu.kicad_sch, 3 MCU, clocks, supplies, debug]

Parts:
C301, C302, C303, C304, C305, C307, C312, C317: 100nF 16V; C_0402_1005Metric; MPN CL05B104KO5NNNC; LCSC C1525
C306, C309, C314: 4.7uF 10V; C_0402_1005Metric; MPN CL05A475MP5NRNC; LCSC C23733
C308: 100pF 50V; C_0402_1005Metric; MPN CL05C101JB5NNNC; LCSC C26409
C310: 10nF 50V; C_0603_1608Metric; MPN CL10B103KB8NNNC; LCSC C1589
C311, C313: 1uF 50V; C_0603_1608Metric; MPN CL10A105KB8NNNC; LCSC C15849
C315, C316: 6.8pF 50V; C_0402_1005Metric; MPN CL05C6R8CB5NNNC; LCSC C318598
FB301: BLM18PG221SN1D; L_0603_1608Metric; MPN BLM18PG221SN1D; LCSC C80165
J301: STDC14; PinHeader_2x07_P1.27mm_Vertical_SMD; MPN FTSH-107-01-L-DV-K; LCSC C5307809
L301: 10uH; L_0805_2012Metric; MPN LQM21FN100M80L; LCSC C162582
L302: 10nH; L_0402_1005Metric; MPN LQG15HS10NJ02D; LCSC C77103
R301: 33; R_0603_1608Metric; MPN 0603WAF330JT5E; LCSC C23140
R302: 10k; R_0603_1608Metric; MPN 0603WAF1002T5E; LCSC C25804
TP301: NRST; TestPoint_Pad_D1.0mm
TP302: BOOT0; TestPoint_Pad_D1.0mm
TP303: VDDA; TestPoint_Pad_D1.5mm
TP304: VFBSMPS; TestPoint_Pad_D1.0mm
U301: STM32WB55RGV6; QFN-68-1EP_8x8mm_P0.4mm_EP6.4x6.4mm; MPN STM32WB55RGV6; LCSC C401505
Y301: 32MHz; Crystal_SMD_2016-4Pin_2.0x1.6mm; MPN NX2016SA-32MHZ-EXS00A-CS06654; LCSC C5441424
Y302: 32.768kHz; Crystal_SMD_3215-2Pin_3.2x1.5mm; MPN NX3215SA-32.768K-STD-MUA-14; LCSC C156244

Connections:
+3V3: C301.1, C302.1, C303.1, C304.1, C305.1, C306.1, C307.1, C308.1, C309.1, FB301.1, J301.3 (VCC), U301.1 (VBAT), U301.30 (VDD), U301.33 (VDDRF), U301.44 (VDDSMPS), U301.45 (VDD), U301.55 (VDDUSB), U301.68 (VDD); also elsewhere on the board
/3 MCU, clocks, supplies, debug/BOOT0: R302.1, TP302.1, U301.5 (PH3)
/3 MCU, clocks, supplies, debug/HSE_IN: U301.35 (OSC_IN), Y301.1
/3 MCU, clocks, supplies, debug/HSE_OUT: U301.34 (OSC_OUT), Y301.3
/3 MCU, clocks, supplies, debug/NRST: C317.1, J301.12 (~RST), TP301.1, U301.8 (NRST)
/3 MCU, clocks, supplies, debug/OSC32_IN: C315.1, U301.3 (PC14), Y302.1
/3 MCU, clocks, supplies, debug/OSC32_OUT: C316.1, U301.4 (PC15), Y302.2
/3 MCU, clocks, supplies, debug/SMPS_LX: L301.1, U301.43 (VLXSMPS)
/3 MCU, clocks, supplies, debug/SMPS_MID: L301.2, L302.1
/3 MCU, clocks, supplies, debug/SPI1_SCK: R301.1, U301.63 (PB3)
/3 MCU, clocks, supplies, debug/SWCLK: J301.6 (JCLK/SWCLK), U301.56 (PA14)
/3 MCU, clocks, supplies, debug/SWDIO: J301.4 (JTMS/SWDIO), U301.54 (PA13)
/3 MCU, clocks, supplies, debug/VCP_RX: J301.13 (VCP_RX), U301.67 (PB7)
/3 MCU, clocks, supplies, debug/VCP_TX: J301.14 (VCP_TX), U301.66 (PB6)
/3 MCU, clocks, supplies, debug/VFBSMPS: C314.1, L302.2, TP304.1, U301.41 (VFBSMPS)
DRV_AIN1: U301.23 (PA8); also elsewhere on the board
DRV_AIN2: U301.24 (PA9); also elsewhere on the board
DRV_BIN1: U301.51 (PA10); also elsewhere on the board
DRV_BIN2: U301.52 (PA11); also elsewhere on the board
DRV_NFAULT: U301.21 (PA6), U301.25 (PC4); also elsewhere on the board
DRV_NSLEEP: U301.6 (PB8); also elsewhere on the board
DRV_NSTALL: U301.27 (PB2); also elsewhere on the board
DRV_RESET: U301.7 (PB9); also elsewhere on the board
DRV_SCS: U301.19 (PA4); also elsewhere on the board
ENC_L_A: U301.9 (PC0); also elsewhere on the board
ENC_L_B: U301.11 (PC2); also elsewhere on the board
ENC_L_Z: U301.26 (PC5); also elsewhere on the board
ENC_R_A: U301.15 (PA0); also elsewhere on the board
ENC_R_B: U301.16 (PA1); also elsewhere on the board
ENC_R_Z: U301.12 (PC3); also elsewhere on the board
FLASH_NCS: U301.57 (PA15); also elsewhere on the board
GND: C301.2, C302.2, C303.2, C304.2, C305.2, C306.2, C307.2, C308.2, C309.2, C310.2, C311.2, C312.2, C313.2, C314.2, C315.2, C316.2, C317.2, J301.5 (GND), J301.7 (GND), J301.11 (GNDDetect), R302.2, U301.32 (VSSRF), U301.42 (VSSSMPS), U301.69 (VSS), Y301.2 (G), Y301.4 (G); also elsewhere on the board
IMU_INT: U301.50 (PC6); also elsewhere on the board
IMU_MISO: U301.48 (PB14); also elsewhere on the board
IMU_MOSI: U301.49 (PB15); also elsewhere on the board
IMU_NCS: U301.46 (PB12); also elsewhere on the board
IMU_SCK: U301.47 (PB13); also elsewhere on the board
LED_DATA: U301.22 (PA7); also elsewhere on the board
LED_GREEN: U301.38 (PB0); also elsewhere on the board
NFC_GPO: U301.17 (PA2); also elsewhere on the board
QWIIC_SCL: U301.28 (PB10); also elsewhere on the board
QWIIC_SDA: U301.29 (PB11); also elsewhere on the board
RF1: U301.31 (RF1); also elsewhere on the board
SPI1_MISO: U301.64 (PB4); also elsewhere on the board
SPI1_MOSI: U301.65 (PB5); also elsewhere on the board
SPI1_SCK_BUS: R301.2; also elsewhere on the board
VBAT_SENSE: U301.10 (PC1); also elsewhere on the board
VDDA: C310.1, C311.1, C312.1, C313.1, FB301.2, TP303.1, U301.13 (VREF+), U301.14 (VDDA)

Notes on the sheet:
VDD bulk
VDDUSB 55
One 100 nF per supply pin, at the pin, each with its own via; 4.7 uF bulk on VDD. VDDRF 100 nF + 100 pF at pin 33. VDDA and VREF+ through FB301: 10 nF + 1 uF on VDDA, 100 nF + 1 uF on VREF+ (mcu-circuit-design s2). VDDUSB to VDD: USB unused (DS11929 s3.7). VBAT to VDD: no backup domain battery.
Debug and virtual COM port: STDC14 (D-009)
L301 10 uH + L302 10 nH (RX performance) + C314 4.7 uF: DS11929 Table 6. L301 / L302 at pins 41-44, small loop, orthogonal to the RF line (docs/rf.md).
VDDRF 33
VDDSMPS 44
Clocks: HSE 32 MHz, LSE 32.768 kHz
LPTIM1_IN2 EXTI5 TIM2_CH1 TIM2_CH2 EXTI3 USART1_TX USART1_RX GPIO SYS_JTMS-SWDIO SYS_JTCK-SWCLK GPIO ADC1_IN2 TIM17_CH1 I2C3_SCL I2C3_SDA GPIO BOOT0 EXTI2
VDD 68
Core SMPS (DS11929 Table 6)
VREF+ 13
Reset, boot and SPI1 clock termination
VDDA 14
STM32WB55RGV6 (UFQFPN-68)
NRST: 100 nF at the pin (DS11929 Fig. 24); the STDC14 probe drives it too. BOOT0 (PH3): 10k pull-down, no button (D-035): TP302 to +3V3 at reset, or the boot option bytes over SWD. R301 33 Ohm at PB3: source termination of the SCK shared by the DRV8711 and the flash (s9).
Test points
VBAT 1
DRV_AIN1 DRV_AIN2 DRV_BIN1 DRV_BIN2 DRV_NFAULT DRV_NFAULT SPI1_SCK SPI1_MISO SPI1_MOSI DRV_SCS DRV_NSLEEP DRV_RESET IMU_SCK IMU_MISO IMU_MOSI IMU_NCS IMU_INT ENC_L_A
PA8 PA9 PA10 PA11 PA6 PC4 PB3 PB4 PB5 PA4 PB8 PB9 PB13 PB14 PB15 PB12 PC6 PC0
VDD 30
PC2 PC5 PA0 PA1 PC3 PB6 PB7 PB0 PA13 PA14 PA15 PC1 PA7 PB10 PB11 PB2 PH3 PA2
STLINK-V3 STDC14 (1.27 mm): SWD + virtual COM port on USART1 (PB6 TX, PB7 RX). SWO (pin 8) unused: PB3 is SPI1_SCK. Pin 3 is the target VCC reference for the probe.
ENC_L_B ENC_L_Z ENC_R_A ENC_R_B ENC_R_Z VCP_TX VCP_RX LED_GREEN SWDIO SWCLK FLASH_NCS VBAT_SENSE LED_DATA QWIIC_SCL QWIIC_SDA DRV_NSTALL BOOT0 NFC_GPO
Pin plan (pin-data/pinmap.csv, checked by scripts/check_pinmap.py)
HSE NX2016SA: no external caps, load trimmed by HSETUNE (DS11929 Table 5 note 1). LSE NX3215SA, C_L 6 pF: 2 x 6.8 pF C0G (AN2867); LSEDRV = 10, margin ~2.5 (Table 54).
TIM1_CH1 TIM1_CH2 TIM1_CH3 TIM1_CH4 TIM1_BKIN EXTI4 SPI1_SCK SPI1_MISO SPI1_MOSI GPIO GPIO GPIO SPI2_SCK SPI2_MISO SPI2_MOSI GPIO EXTI6 LPTIM1_IN1
Supplies and decoupling (DS11929 Fig. 16)
VDD 45

Board: 4 copper layers, 244 parts (0 on the bottom side), 127 nets, no tracks yet.

Other parts of the board:
MB1, MB2, MB3, MB4: bracket M3; MountingHole_M3_NPTH_KeepOut7mm
MB5, MB6, MB7, MB8: bracket M2; MountingHole_M2_NPTH_KeepOut5.5mm
MC1, MC2, MC3, MC4: battery cradle; MountingHole_M3_NPTH_KeepOut7mm
MH1: bumper; MountingHole_M3_NPTH_KeepOut7mm
MH2: bumper (nylon); MountingHole_M3_NPTH_KeepOut7mm
