embedded-pro/e-inverted-pendulum-hardware/scripts/export_bom.py

#!/usr/bin/env python3
"""Export the schematic BOM: bom/bom.csv (stock-check format) and bom/bom_jlc.csv (JLCPCB assembly format).

DNP parts and parts excluded from the BOM (antenna, net ties, test points) are left out.
Lines are grouped by LCSC number.

Usage: export_bom.py [hardware/e-inverted-pendulum/e-inverted-pendulum.kicad_sch]
"""

import csv
import io
import pathlib
import subprocess
import sys

ROOT = pathlib.Path(__file__).resolve().parent.parent


def main():
    schematic = pathlib.Path(sys.argv[1]) if len(sys.argv) > 1 else ROOT / "hardware" / "e-inverted-pendulum" / "e-inverted-pendulum.kicad_sch"
    out = ROOT / "bom" / "raw_bom.csv"
    subprocess.run(["kicad-cli", "sch", "export", "bom", "--exclude-dnp", "--fields",
                    "Reference,Value,Footprint,LCSC,MPN,${QUANTITY}", "--labels", "Reference,Value,Footprint,LCSC,MPN,Qty",
                    "--group-by", "LCSC", "--ref-range-delimiter", "", "-o", str(out), str(schematic)],
                   check=True, capture_output=True)
    rows = list(csv.DictReader(io.StringIO(out.read_text(encoding="utf-8"))))
    out.unlink()
    rows = [r for r in rows if r["LCSC"]]
    rows.sort(key=lambda r: r["Reference"])
    with open(ROOT / "bom" / "bom.csv", "w", newline="", encoding="utf-8") as handle:
        writer = csv.writer(handle)
        writer.writerow(["group", "function", "mpn", "lcsc", "qty", "notes"])
        for row in rows:
            writer.writerow(["schematic", row["Value"], row["MPN"], row["LCSC"], row["Qty"], row["Reference"]])
    with open(ROOT / "bom" / "bom_jlc.csv", "w", newline="", encoding="utf-8") as handle:
        writer = csv.writer(handle)
        writer.writerow(["Comment", "Designator", "Footprint", "LCSC Part #"])
        for row in rows:
            writer.writerow([row["Value"], row["Reference"], row["Footprint"].split(":")[-1], row["LCSC"]])
    print(f"{len(rows)} BOM lines, {sum(int(r['Qty']) for r in rows)} placements -> bom/bom.csv, bom/bom_jlc.csv")


if __name__ == "__main__":
    main()
