embedded-pro/e-inverted-pendulum-hardware/(commit log)

2026-11-04 docs: add chassis PCB plan for schematic, simulation and layout
    Captures the locked design decisions (STM32WB55RGV6 with the Nucleo pin
    map, one DRV8711 driving two brushed DC motors with ABZ encoders,
    MPU-6500, W25Q16 SPI flash, 3S LiPo, printed IFA, JLC 4-layer 1.6 mm),
    the JLCPCB part selection with LCSC numbers, and the phased plan for
    schematic, ngspice simulation and layout, following the hardware-design
    skills.
    Claude-Session: https://claude.ai/code/session_014WUWh5VkSPnHwtWn45y92W
2026-11-04 feat: phase 0 requirements, pin map, sizing and BOM
    - Repo bootstrap: CLAUDE.md with skill routing and rules, hardware-skills
    marketplace in .claude/settings.json, .gitignore.
    - docs/requirements.md: hardware requirements traced to firmware REQ IDs.
    - docs/decisions.md: D-001..D-012 agreed; D-013..D-015 proposed for the
    phase 0 gate (motor 1:9.6, 1.3 A trip with firmware I2t, motors on the
    bottom side).
    - Pin map for STM32WB55RGV6 kept 1:1 with the firmware; check_pinmap.py
    validates bonding, alternate functions, EXTI uniqueness and parity with
    the firmware's declared pins (26/26). Package data extracted from
    KiCad's ST-generated symbol.
    - simulation/sizing.py (S0): firmware pend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
    [mass_budget.csv, parts.csv, pinmap.csv, sizing_sweep.csv, stm32wb55rgvx_vfqfpn68.csv]
2026-11-04 chore: close phase 0 gate, move toolchain to KiCad 10, add datasheet fetcher
    - D-013..D-015 signed off; D-016 records the generic ABZ encoder
    interface (PH 5-pin, 5V0 with 3V3 option, DNP open-collector pull-ups).
    - D-010 now KiCad 10.0.8 from the official PPA; pin data regenerated from
    the KiCad 10 STM32WB55RGVx symbol (identical) and check_pinmap passes.
    - scripts/fetch_datasheet.py pulls datasheets via the JLC parts API into
    the gitignored datasheets/ folder with pdftotext copies.
    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
2026-11-04 feat(schematic): generated KiCad 10 schematic, custom library, design calcs
    - kicad/gen: S-expression writer, symbol loader (flattens extends), sheet
    emitter with pin stubs + labels, rotation for two-pin passives, power
    symbols / global labels; 8 design modules (power entry, logic power,
    MCU, RF, drive, motors + encoders, IMU + flash, UI). MCU pin nets come
    from pin-data/pinmap.csv.
    - kicad/lib: DRV8711, MPU-6500, MLPF-WB55-01E3 symbols; MLPF, XT30UPB-F,
    SS-12D10L5, MLT-8530, TS-1187A footprints from datasheet land patterns.
    - scripts/design_calcs.py -> docs/design-calcs.md + kicad/gen/values.json
    (TPS62933F divider/UVLO/L, LSE caps, VBAT divider, soft start, DRV8711
    support pa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
    [drive.kicad_sch, e-inverted-pendulum.kicad_sch, imu_flash.kicad_sch, logic_power.kicad_sch, mcu.kicad_sch, motors_encoders.kicad_sch, parts.csv, power_entry.kicad_sch]
2026-11-04 feat: phase 1 verification, BOM export, CI, gate checklist
    - scripts/check_library.py: every symbol pin <-> footprint pad (171 pairs).
    - scripts/export_bom.py: schematic BOM -> bom/bom.csv and bom/bom_jlc.csv;
    jlc_stock.py confirms all 64 lines in stock for 5 boards.
    - Deterministic pin UUIDs for multi-unit symbols, so regenerating the
    schematic is byte-identical; CI regenerates and requires no diff.
    - .github/workflows/hardware.yml (kicad/kicad:10.0.8): pin map, regenerate
    + diff, ERC, netlist and library checks.
    - docs/checklists/phase1.md: mcu-circuit-design s12, analog s10, rf-layout,
    interface-layout s2 and safety-chain items with evidence and open items.
    - docs/firmware-interfa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
    [bom.csv, bom_jlc.csv, drive.kicad_sch, motors_encoders.kicad_sch, power_entry.kicad_sch]
2026-11-04 feat(simulation): phase 2 ngspice suite S1-S5; fix hot-plug turn-on and phase-node undershoot
    Suite (simulation/, one command: run_all.py), values read from the
    KiCad schematic, datasheet-derived device models in models/devices.lib
    (R_DS(on) cross-checked against datasheets), TI models fetched, not
    committed:
    - S1 power entry: the Phase 1 Miller soft-start turned the AO4805 on
    during hot plug even with the switch off (VBAT 10.5 V, 43-45 A spikes
    above the 40 A pulse rating). Fix: R102 100k, C101 47n, new C102 1u
    gate-source -> 0.54 A inrush, FET stays off on hot plug (D-021).
    - S2 H-bridge: dead-time freewheel held the DRV8711 phase pins at
    -0.73 V for ~3 us per period (abs max -0.6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
    [bom.csv, bom_jlc.csv, drive.kicad_sch, imu_flash.kicad_sch, motors_encoders.kicad_sch, parts.csv, power_entry.kicad_sch, ui.kicad_sch]
2026-11-04 Re-baseline mechanics for the 85 x 130 mm plate (D-024)
    - mass_budget.csv: 85 x 130 x 1.6 mm plate, battery centre 60 mm above the
    axle, explicit axle row (pivot on the motor axis, 14 mm behind the plate).
    - sizing.py: CoM, l and lean measured from the axle; ties at the 34 deg
    search ceiling broken by recovery at the rated-current limit; lean for
    the battery on either face.
    - S0 rerun: m 0.392 kg, l 26.3 mm, tau 86 ms; 1:9.6 still chosen.
    Static lean is about 21 deg toward the top side (Phase 0 said 7 deg from
    the wrong pivot); 9.8 deg with the battery on the bottom side.
    - mechanical.md: new zones, motor overhang and mount slots, open items.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
    [mass_budget.csv, sizing_sweep.csv]
2026-11-04 RF design: 50 ohm GCPW for JLC04161H-7628, antenna and RF layout rules
    - scripts/gcpw.py: conductor-backed CPW with thickness correction;
    reproduces ST's DS12804 Fig. 13 line (47.9 ohm on its 2-layer stack-up).
    50 ohm on L1 over L2: 0.27 mm track, 0.15 mm gap; corners 42.7-57.3 ohm.
    - docs/rf.md: MLPF IN trace copied from DS12804 Fig. 13 (1.5 mm, 200/104 um),
    recalculated 50 ohm section, SWRA117D IFA in the top-left corner with an
    all-layer keep-out, via fence 1.0-1.3 mm, pi and U.FL footprints, SMPS and
    crystal rules, open items (AN5165/AN2867 check, JLC impedance control).
    Claude-Session: https://claude.ai/code/session_014W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
    [gcpw.py]
2026-11-04 Board set-up: outline, stack-up, keep-outs, footprints, net classes, JLC rules
    - kicad/gen/board.py: scripted Update PCB from Schematic (176 footprints,
    168 nets, sheet paths, DNP/BOM flags), 85 x 130 mm outline with 1 mm
    radii and strap slots, JLC04161H-7628 stack-up, motor-mount slots and
    bumper holes (board-only), antenna keep-out and battery-zone rule areas,
    reference drawings. Re-runs are byte-identical and never move locked parts.
    - docs/power-map.md: power map per power-pcb-layout s2; net classes derived
    from it. JLC rules applied with pcb_rules.py (pcb-design-rules skill).
    - Mechanical footprints (M3 NPTH hole and slot with copper keep-out);
    footprint generation made dete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
    [e-inverted-pendulum.kicad_pcb]
2026-11-04 Anchor draft for gate A: placement, renders, layout doc
    - placement.py: 41 anchor proposals (connectors, antenna, MCU and RF
    path, IMU, DRV8711 and bridges, power path, buck, UI) plus the six
    mechanical items. Nothing is locked until the owner approves.
    - RF corner: MCU rotated 180 deg so RF1 faces the antenna; MLPF IN 1.5 mm
    from the RF1 pad; OUT, pi and the feed on one line (x = -29.0).
    - Power stage: DRV8711 rotated 90 deg, gate-drive pins toward both FET
    pairs; Rsense between each pair's sources; bulk centred.
    - board.py: footprints follow library edits (pads, zones, description);
    anchor table generated into docs/layout.md.
    - Mechanical keep-outs on the outer layers only; inner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
    [e-inverted-pendulum.kicad_pcb]
2026-11-13 Re-size for the owner's hardware: MG310 1:20, WHEELTEC bracket, 65 mm wheels
    - Decisions D-025..D-031: battery on the back, WHEELTEC U-bracket in the
    bottom 25 mm strip, MG310 on 3S with a 7.4 V firmware cap and 2.0 A trip,
    one PH 6-pin per motor (no index), owner floorplan, ST25DV04KC NFC tag,
    M24C64 EEPROM. Superseded rows marked (D-002, D-013..D-016, D-024).
    - sizing.py: MG310 model (constants derived from the listing, assumptions
    stated), voltage-cap x trip sweep; mass budget for the bracket, motors,
    back-mounted battery and 65 mm wheels.
    - S0: m 0.387 kg, l 29.6 mm, tau 84 ms, lean 17 deg toward the front;
    1.0-1.5 A trips recover 12-17 deg, 2.0 A recovers 22 deg -> trip 2.0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
    [mass_budget.csv, sizing_sweep.csv]
2026-11-13 Schematic: MG310 PH 6-pin connectors, NFC tag, I2C EEPROM, NFC coil
    - Sheet 6: one JST PH S6B-PH-K-S per motor (MG310 pinout: M-, enc VCC,
    A, B, GND, M+); index chain removed, buffer third input grounded so
    PC5/PC3 read low (D-028).
    - Sheet 8: M24C64-RMN6TP at 0x50 and ST25DV04KC-IE8S3 at 0x53/0x57 on
    I2C3; GPO (open drain, 10k) to PA2/EXTI2; DNP 2.7 pF coil trim (D-030,
    D-031). New project symbols ST25DV04KC-IE8S3 and NFC_Coil.
    - scripts/nfc_coil.py: 25 x 21 mm, 10-turn printed loop, 4.25 uH by
    Greenhouse (modified Wheeler -0.2 %), f0 14.2 MHz with C_TUN 28.5 pF;
    writes the net-tie footprint. docs/nfc.md.
    - Pin map: NFC_GPO on PA2 (EXTI2); index rows marked unused.
    - ERC 0, netl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
    [bom.csv, bom_jlc.csv, mcu.kicad_sch, motors_encoders.kicad_sch, parts.csv, pinmap.csv, ui.kicad_sch]
2026-11-13 Anchor draft v2 for gate A: owner floorplan, WHEELTEC bracket, NFC coil
    - placement.py v2 (D-025..D-031): MCU top centre with the IFA above RF1
    and a full-width 2.4 GHz keep-out band; IMU beside the MCU's SPI2 pins;
    NFC coil top-right with the ST25DV and EEPROM at its terminals; STDC14
    mid right edge; MG310 PH 6-pin sockets on both side edges; XT30 on the
    left edge; bridge in the lower centre; empty 25 mm bracket strip with
    the WHEELTEC hole patterns (M3 64x17, 2.4 mm 77x14).
    - Battery on the back at z 40-75 with cradle holes; custom DRC rules: no
    THT pin under the battery, no part in the bracket strip (both verified
    to fire on a test copy); no B.Cu copper in the strip.
    - board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
    [e-inverted-pendulum.kicad_pcb, mass_budget.csv, sizing_sweep.csv]
2026-11-13 Hand PCB placement to the owner: clean-slate board, add-only generator
    The owner will arrange the components in KiCad (D-032), so the board file
    becomes the source of truth for placement and board geometry.
    - kicad/gen/board.py: never moves, reshapes or deletes what is on the
    board. Outline, rule areas, reference drawings and bracket holes are
    created only when missing; new schematic parts go to the staging area;
    library swaps keep position, rotation and lock; board-only footprints
    are never deleted. New one-shot --stage-all packs every unlocked part
    (except the bracket holes) beside the board, one column per sheet,
    without overlaps. Page set to A3 so the staging area fits.
    - pl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
    [e-inverted-pendulum.kicad_pcb]
2026-11-13 refactor: move to the e-psu-hardware repository layout
    No functional change. The KiCad project moves to hardware/e-inverted-pendulum/
    (schematic, board, rules, project symbols and footprints, library tables
    pointing at ${KIPRJMOD}); the schematic generator moves to scripts/schgen/,
    the board tooling to scripts/pcb/ (render_board.py -> render.py) and the
    renders to docs/images/. Paths updated in the scripts, simulation,
    CI, docs and .gitignore (e-psu entries for review_exports/, manufacturing/,
    release/, diff/).
    Checked: regenerated schematics differ only in the generator-path comment;
    libraries unchanged; ERC 0; pin map (with firmware), netlist and library
    checks pass; board.py output byte-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
    [drive.kicad_sch, e-inverted-pendulum.kicad_pcb, e-inverted-pendulum.kicad_sch, imu_flash.kicad_sch, logic_power.kicad_sch, mcu.kicad_sch, motors_encoders.kicad_sch, power_entry.kicad_sch]
2026-11-13 feat(schematic): redraw all sheets in the e-psu-hardware style
    Port e-psu's schematic engine (scripts/schgen/sch.py) to KiCad 10 and redraw
    the 8 sheets with it: one titled box per functional block, circuits wired with
    rails and links, a design note in each box, and a root page that describes
    every sheet plus the power flow and grounding.
    The circuit is unchanged. check_equivalence.py compares the new netlist with
    the previous revision: same 175 parts, values, footprints, LCSC/MPN/Purpose
    fields, DNP flags, net names and pin connectivity. The PCB is byte-identical
    after a board.py sync, and schematic-parity DRC finds no footprint errors.
    - sch.py: deterministic UUIDs (rebuilds are byte-ide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
    [drive.kicad_sch, e-inverted-pendulum.kicad_sch, imu_flash.kicad_sch, logic_power.kicad_sch, mcu.kicad_sch, motors_encoders.kicad_sch, power_entry.kicad_sch, rf.kicad_sch]
2026-11-13 docs: README, PROJECT_CONTEXT and kicad MCP config in the e-psu shape
    - README rewritten like e-psu-hardware: status, highlights, sheet table,
    requirement summary with sources, repository layout, checks, how to
    change the schematic, before ordering, CI
    - PROJECT_CONTEXT.md: design summary, simulation findings, PCB state,
    open items, repository map
    - .mcp.json: kicad-mcp-pro on hardware/ with the schematic profile, as in
    e-psu-hardware
    - CLAUDE.md: exporters and the review agent; plan.md repository layout
    The design guide, review agent, exporters and CI workflows referenced here
    follow in the next commit.
    Claude-Session: https: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
2026-11-13 ci: port the e-psu exporters, kicad-bot, visual diff and release-please
    Scripts (outputs gitignored, same layout as e-psu-hardware):
    - export_review.py: ERC/DRC with schematic parity, BOM, PDFs, gerbers and
    layer views -> review_exports/e-inverted-pendulum/
    - export_jlcpcb.py: gerbers, drill, BOM and CPL for JLCPCB, BOM taken from
    export_bom.py (tracked bom/ untouched), BOM-vs-CPL designator check,
    optional live stock check; gerbers and drill use the board's drill origin
    so they line up with the CPL
    - export_release.py: release zip; fails without a zip if any step fails
    - visual_diff.py: red/green schematic and board diff, inner layers included
    Workflows (actions pinned to the e-psu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
    [export_jlcpcb.py, export_release.py, export_review.py, visual_diff.py]
2026-11-13 docs: robot hardware design guide and the board review agent
    - docs/robot-hardware-design-guide.md: component-agnostic knowledge base for
    battery-powered motor-control robots whose PCB is the chassis, in the shape
    of e-psu's PSU guide: power path, rails, MCU, RF, H-bridge and sense,
    encoders, IMU, NFC, buses, mechanics, thermal, layout, KiCad/JLCPCB, a
    go/no-go checklist and the list of assumptions and rules of thumb
    - .claude/agents/pendulum-board-reviewer.md: read-only reviewer working from
    review_exports/, with requirements.md as the contract, REPORT.md as the
    evidence and the guide as the rubric; respects the phase gates and owner
    placement (D-032)
    Fixes found while writin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
    [e-inverted-pendulum.kicad_pcb, imu_flash.kicad_sch, parts.csv]
2026-11-13 ci: fix ERC in the KiCad container; kicad-bot to manual runs
    - hardware.yml: the kicad/kicad:10.0.8 container ships no global symbol or
    footprint library tables, so ERC reported 466 "library not in the
    configuration" violations (287 symbol, 179 footprint) on every run since
    08b2a3e. Seed both tables from KiCad's templates and point
    KICAD_CONFIG_HOME at them. Reproduced locally with an empty config:
    466 violations before, 0 after.
    - kicad-bot.yml: v0.1.3 installs KiCad 9.0.8 even with kicad-version "10",
    and KiCad 9 can't load this KiCad 10 project ("Failed to load
    schematic"). Manual trigger only until kicad-bot installs KiCad 10;
    hardware.yml stays the ERC gate.
    Co-Authored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
2026-11-14 feat(schematic): RGB LED chain, no buttons or buzzer, strategic test pads
    The robot doubles as a children's toy, so LEDs replace the buzzer and the
    buttons (D-035, supersedes the HW-IF-002 UI from the D-009 review).
    - Removed: user button (SW801 + R/C), BOOT0 button (SW301, R303; R302
    pull-down stays), buzzer (BZ801, Q801, D803, R805-R807), red LED on PB1.
    - Added: 12 x WS2812B-2020-V6 (C52917434) on +5V, driven from PA7
    (TIM17_CH1 + DMA, LED_DATA) through an SN74AHCT1G125 (C7484): LED V_IH is
    0.55 VDD = 2.75 V at 5 V, only 0.15 V below a 3.3 V GPIO's V_OH. 10k
    pull-down keeps the data low in reset, 33 R source termination, 100 nF
    per LED. The green status LED on PB0 (firmware sta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
    [bom.csv, bom_jlc.csv, drive.kicad_sch, e-inverted-pendulum.kicad_pcb, e-inverted-pendulum.kicad_sch, imu_flash.kicad_sch, logic_power.kicad_sch, mcu.kicad_sch]
2026-11-14 feat(pcb): references only on the board; JLCPCB + Seeed rules; portable RF line
    Silkscreen (D-035):
    - board.py label_fields: every footprint shows only its reference; test
    pads show their net name instead (moved onto F.SilkS once, then the
    owner's); net ties stay unlabelled. Silk text is raised to the fab
    minimum (1.0 / 0.15 mm), never lowered.
    - Project footprints: Value hidden, reference and silk labels at
    1.0 / 0.15 mm. Clears all 48 text_height / text_thickness warnings.
    Fab rules (D-034):
    - pcb_rules apply --fab jlcpcb,seeed: track/space 0.1016 (inner 0.15),
    via 0.20/0.40, via ring 0.10, PTH ring 0.152, hole-to-hole 0.30,
    hole-to-copper 0.3048, edge 0.30, NPTH >= 0.50. Desi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
    [e-inverted-pendulum.kicad_pcb]
2026-11-14 fix(pcb): JLCPCB only (D-036); 50 ohm line back to 0.27 mm
    The boards are ordered from JLCPCB, so D-034 (strictest of JLCPCB and Seeed)
    is superseded by D-036:
    - board.py applies pcb_rules --fab jlcpcb: track / space 0.09, via
    0.15 / 0.25, via ring 0.05, PTH ring 0.15, edge 0.20 (design values
    unchanged).
    - gcpw.py back to the JLC04161H-7628 optimum: 0.27 / 0.15 mm, 49.8 ohm,
    corners 42.7-57.3 ohm (return loss >= 22 dB); RF net class 0.27.
    - Kept: RF1 rule 0.104 mm (the DS12804 gap), NFC via pads 0.65 mm (ring
    margin), silk text 1.0 / 0.15 mm (JLC's own minimum).
    - Docs: decisions (D-034 superseded, D-036), rf, power-map, layout, README
    order notes, PROJECT_CONTEXT, CLAUDE.md.
    Ver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
    [e-inverted-pendulum.kicad_pcb]
2026-11-14 fix(bom): TPD4E05U06QDQARQ1 replaces TPD4E05U06DQAR on the connector ESD
    C138714 (TPD4E05U06DQAR) went to 0 stock at JLCPCB on 2026-11-14 and came
    back the same day; the owner chose to move off it. U601, U603 and U801
    are now TPD4E05U06QDQARQ1 (C81353, 2,365 in stock): the AEC-Q101 version
    of the same TI part, SLVSCO7A. Same USON-10 (DQA) package, pinout (IO 1,
    2, 4, 5; GND 3, 8; NC 6, 7, 9, 10), V_RWM 5.5 V, 0.5 pF and IEC 61000-4-2
    +/-12 kV contact, so symbol, footprint and layout are unchanged. C138714
    stays in parts.csv as the alternate.
    Verified: check_equivalence HEAD differs only in U601/U603/U801 value,
    MPN and LCSC; check.py 127 nets; ERC 0; check_netlist, check_library,
    check_pinm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
    [bom.csv, bom_jlc.csv, e-inverted-pendulum.kicad_pcb, motors_encoders.kicad_sch, parts.csv, ui.kicad_sch]
2026-11-14 ci: KiCad 10 on Ubuntu 26.04 runners; kicad-bot v0.1.5 back on push and PR
    ubuntu-latest is Ubuntu 26.04, whose amd64v3 architecture variant makes apt
    read only binary-amd64v3 indexes. The KiCad PPA builds KiCad for amd64 only,
    so every runner-side install got Ubuntu's KiCad 9.0.8:
    - kicad-bot failed with "Failed to load schematic" (it was manual-only);
    - kicad-diff passed but rendered nothing (render FAIL on every file);
    - release.yml would have built the bundle with KiCad 9.
    - scripts/install_kicad.sh: adds the PPA, pins its .sources to the dpkg
    architecture, installs, and fails unless kicad-cli is the requested major.
    kicad-diff.yml and release.yml use it.
    - kicad-bot v0.1.5 (embedde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
